owenosborn/imx6ulz-brain/production-r0/pictures/EX-PCB-10108-001_top.png

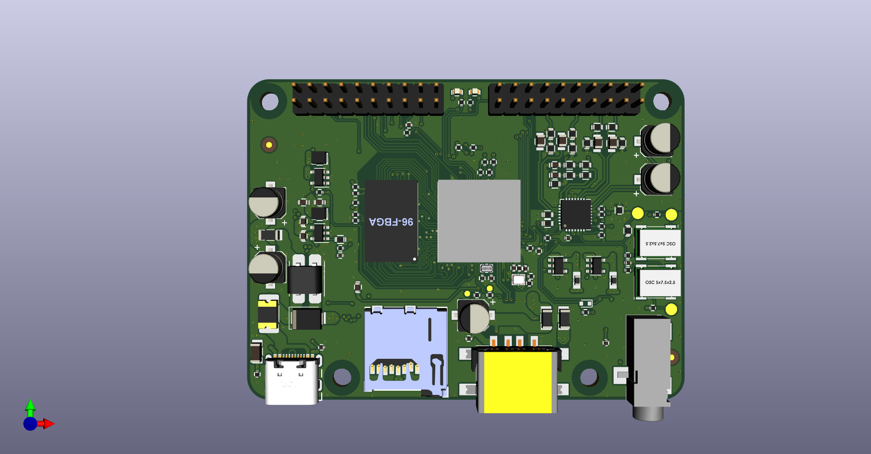
production-r0/pictures/EX-PCB-10108-001_top.png
