owenosborn/imx6ulz-brain/documentation/Audio Codec Board - PROTO_v102_Schematic.PDF

# Audio Codec Board - PROTO schematic v102

## STEREO

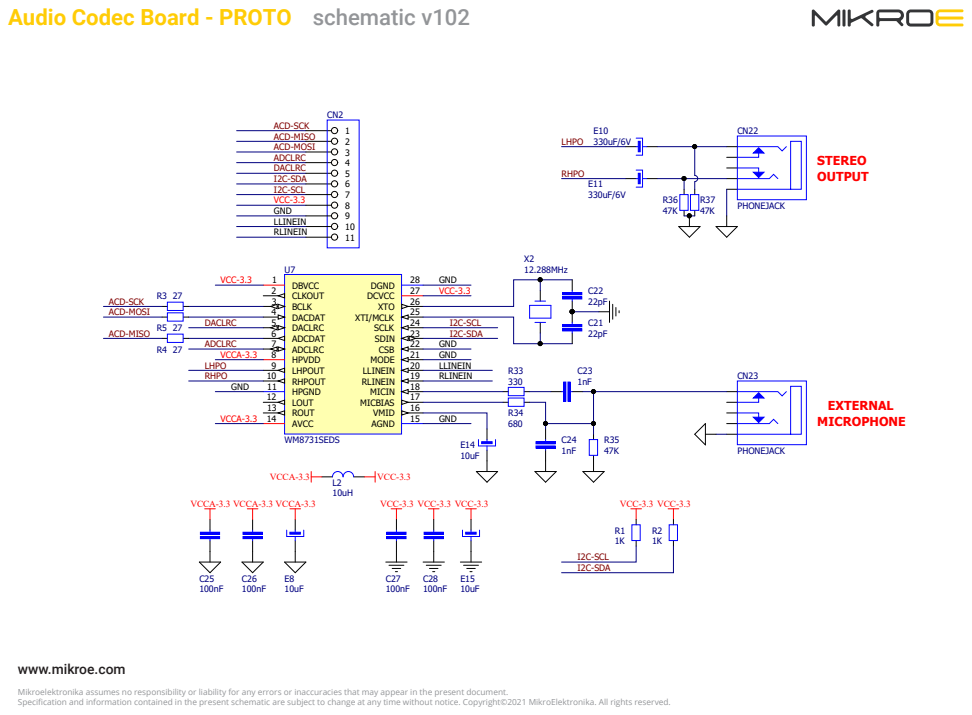
[picture p3: page 1]

Mikroelektronika assumes no responsibility or liability for any errors or inaccuracies that may appear in the present document.
Specification and information contained in the present schematic are subject to change at any time without notice. Copyright©2021 MikroElektronika. All rights reserved.
