owenosborn/imx6ulz-brain/production-r0/schematic/EX-PCB-10108-001.pdf

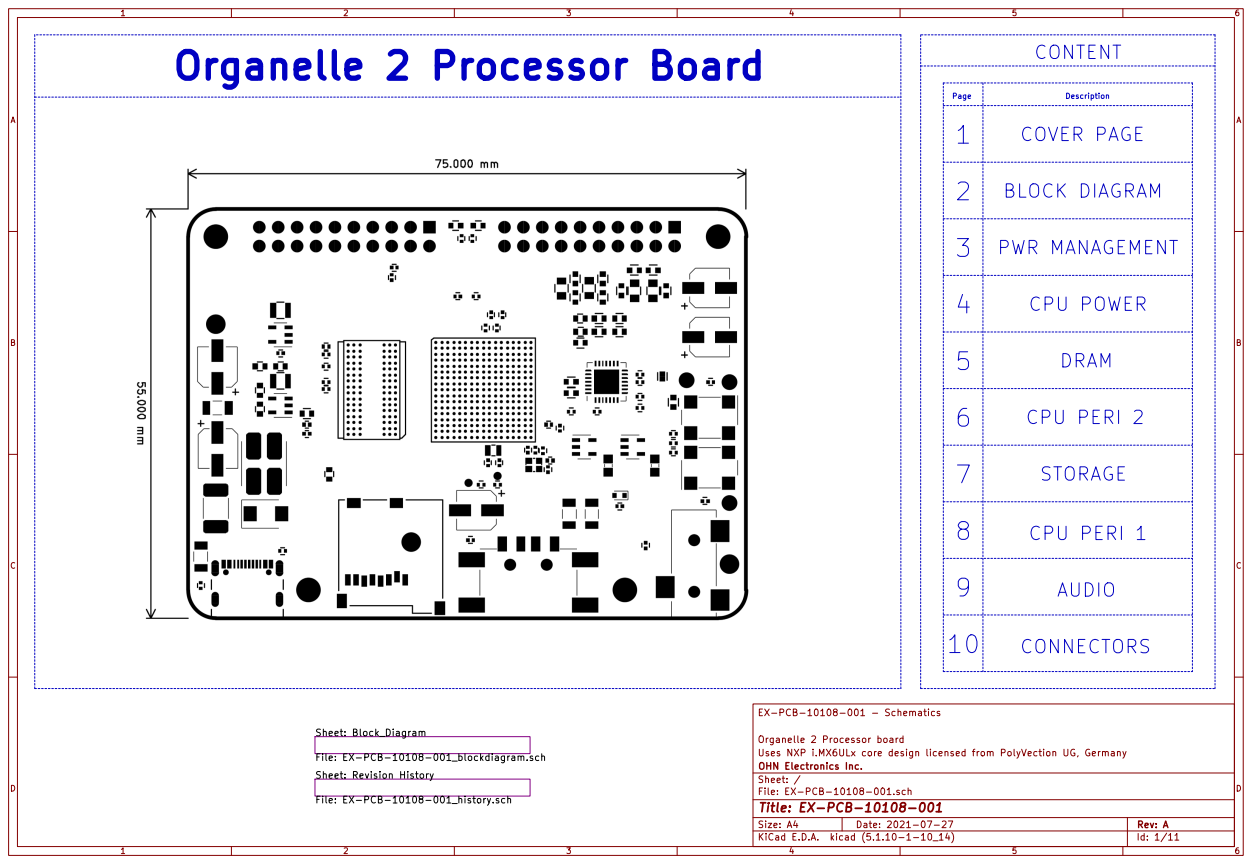
[picture p4: page 1]

2 | BLOCK DIAGRAM

3 | PWR MANAGEMENT

CPU POWER

5 | | DRAM

6 | CPU PERI 2

7 | STORAGE

8 | CPU PERI 1

9 | AUDIO

Organelle 2 Processor board EX-PCB-10108-001 - Schematics Sheet: Block_Diagram

File: EX-PCB-10108-001.sch Sheet: / OHN Electronics Inc. Uses NXP i.MX6ULx core design licensed from PolyVection UG, Germany

File: EX-PCB-10108-001_blockdiagram.sch
Sheet: Revision History

Id: 1/11 Title: EX-PCB-10108-001

File: EX-PCB-10108-001_history.sch

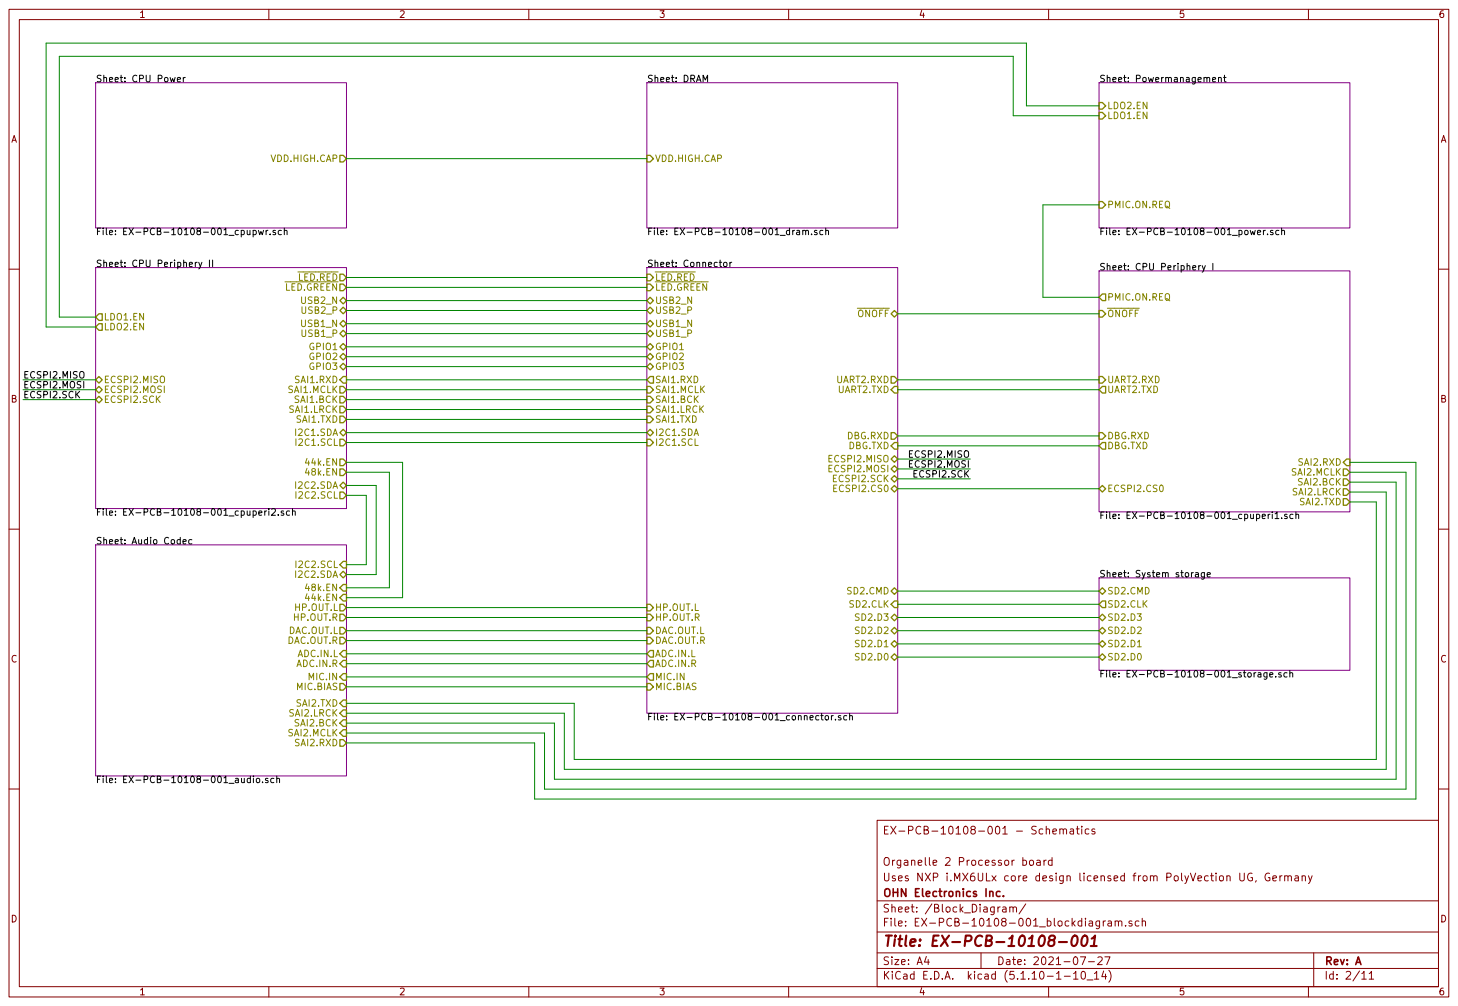
[picture p5: page 2]

File: EX-PCB-10108-001_dram.sch VDD.HIGH.CAP

File: EX-PCB-10108-001_power.sch PMIC.ON.REQ

Sheet: CPU Periphery II

ECSPI2.CS0 Sheet: Connector File: EX-PCB-10108-001_connector.sch USB2_N
LED.RED
LED.GREEN
UART2.RXD ONOFF ECSPI2.MISO

File: EX-PCB-10108-001_cpuperi1.sch PMIC.ON.REQ

File: EX-PCB-10108-001_cpuperi2.sch

I2C2.SCL
I2C2.SDA MIC.IN MIC.BIAS
SAI2.MCLK HP.OUT.L HP.OUT.R

Sheet: System storage
SD2.CMD
File: EX-PCB-10108-001_storage.sch SD2.CLK

HP.OUT.L
HP.OUT.R
DAC.OUT.L ADC.IN.R
ADC.IN.L DAC.OUT.R

DAC.OUT.L DAC.OUT.R

Organelle 2 Processor board EX-PCB-10108-001 - Schematics

Sheet: /Block_Diagram/ OHN Electronics Inc. Uses NXP i.MX6ULx core design licensed from PolyVection UG, Germany

File: EX-PCB-10108-001_blockdiagram.sch
Id: 2/11 Title: EX-PCB-10108-001

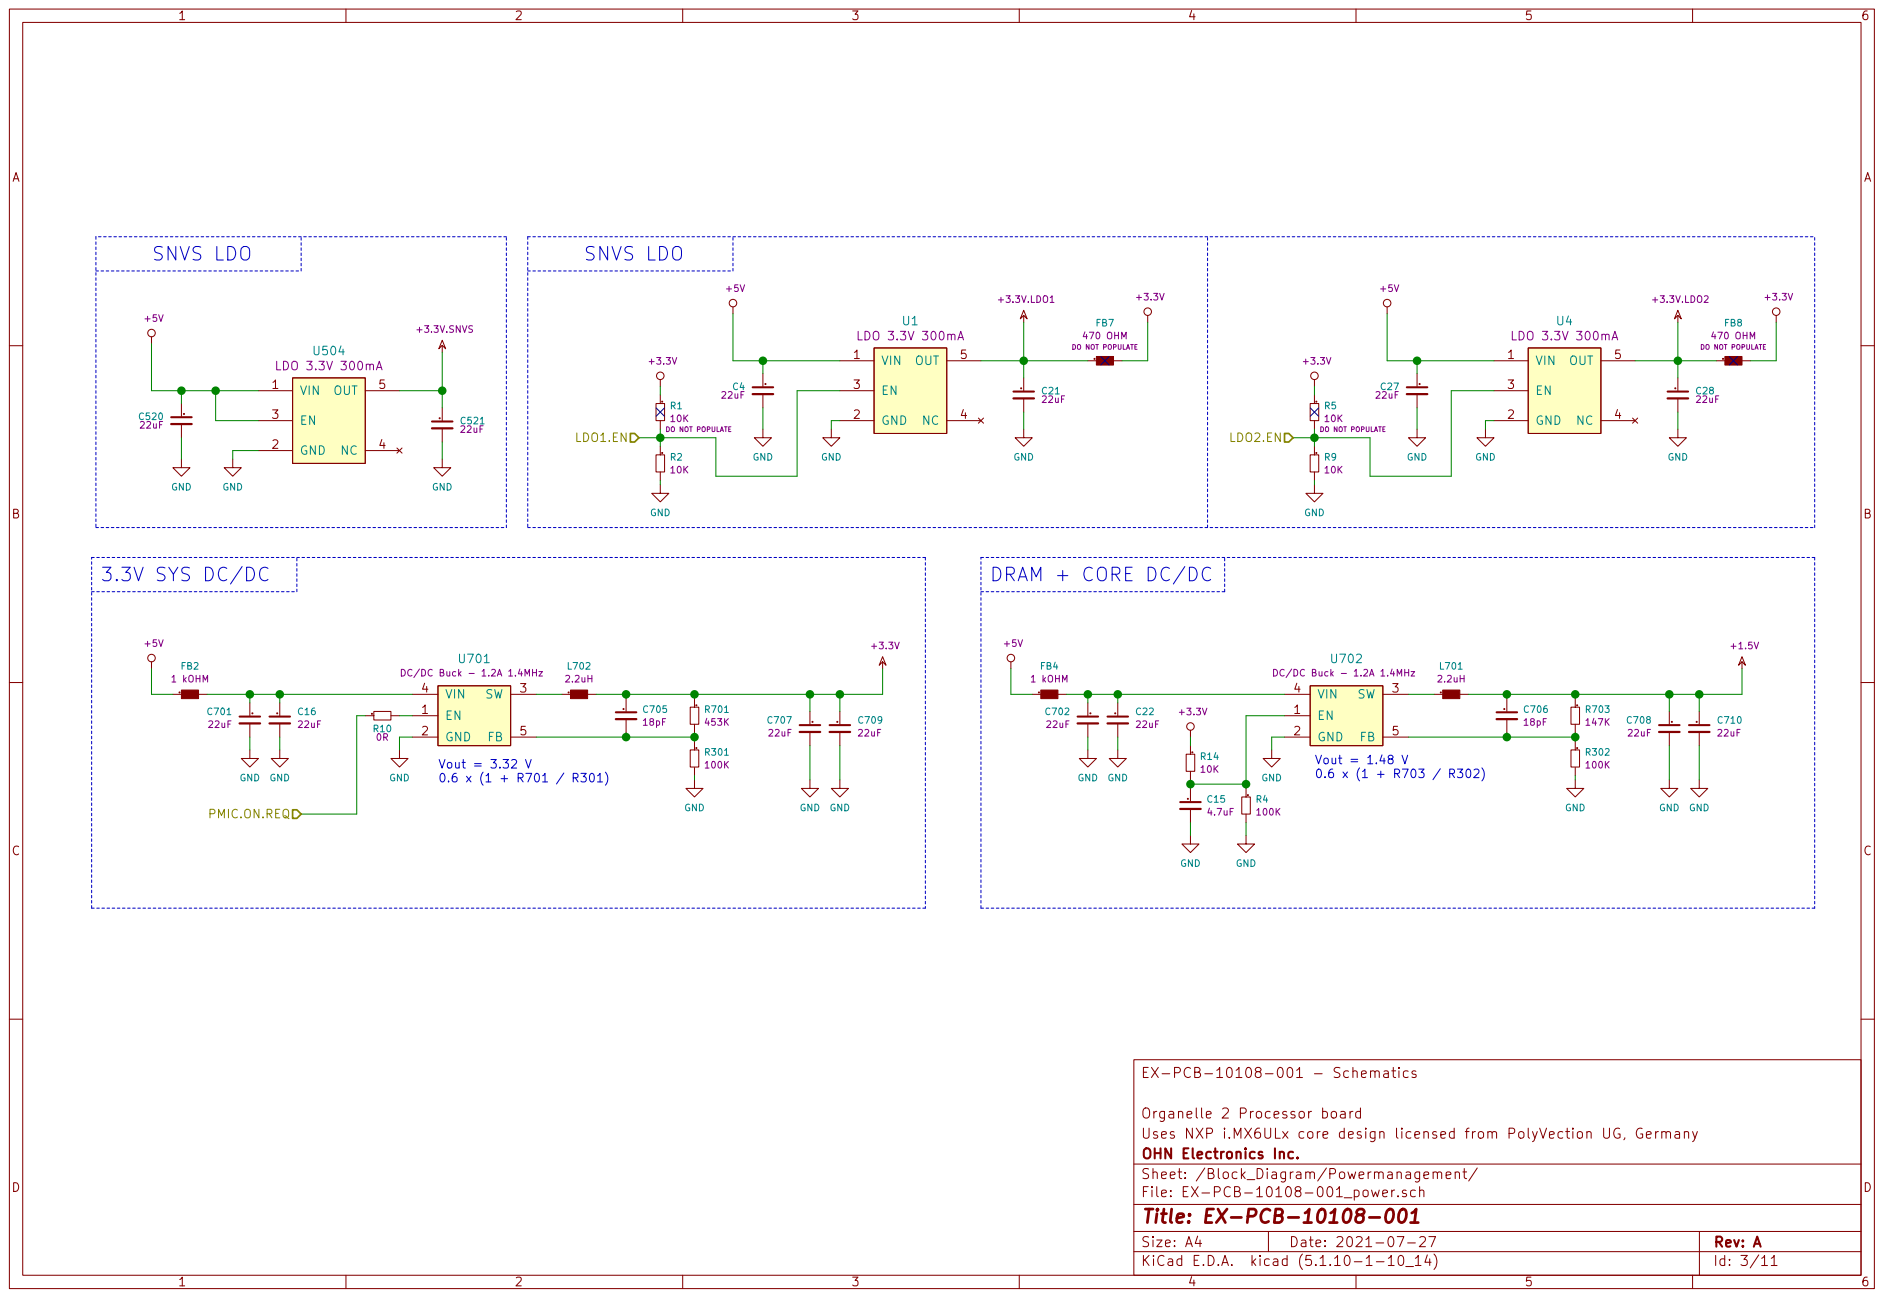
[picture p6: page 3]

DO NOT POPULATE GND

Organelle 2 Processor board EX-PCB-10108-001 - Schematics

Sheet: /Block_Diagram/Powermanagement/ OHN Electronics Inc. Uses NXP i.MX6ULx core design licensed from PolyVection UG, Germany

File: EX-PCB-10108-001_power.sch
Id: 3/11 Title: EX-PCB-10108-001

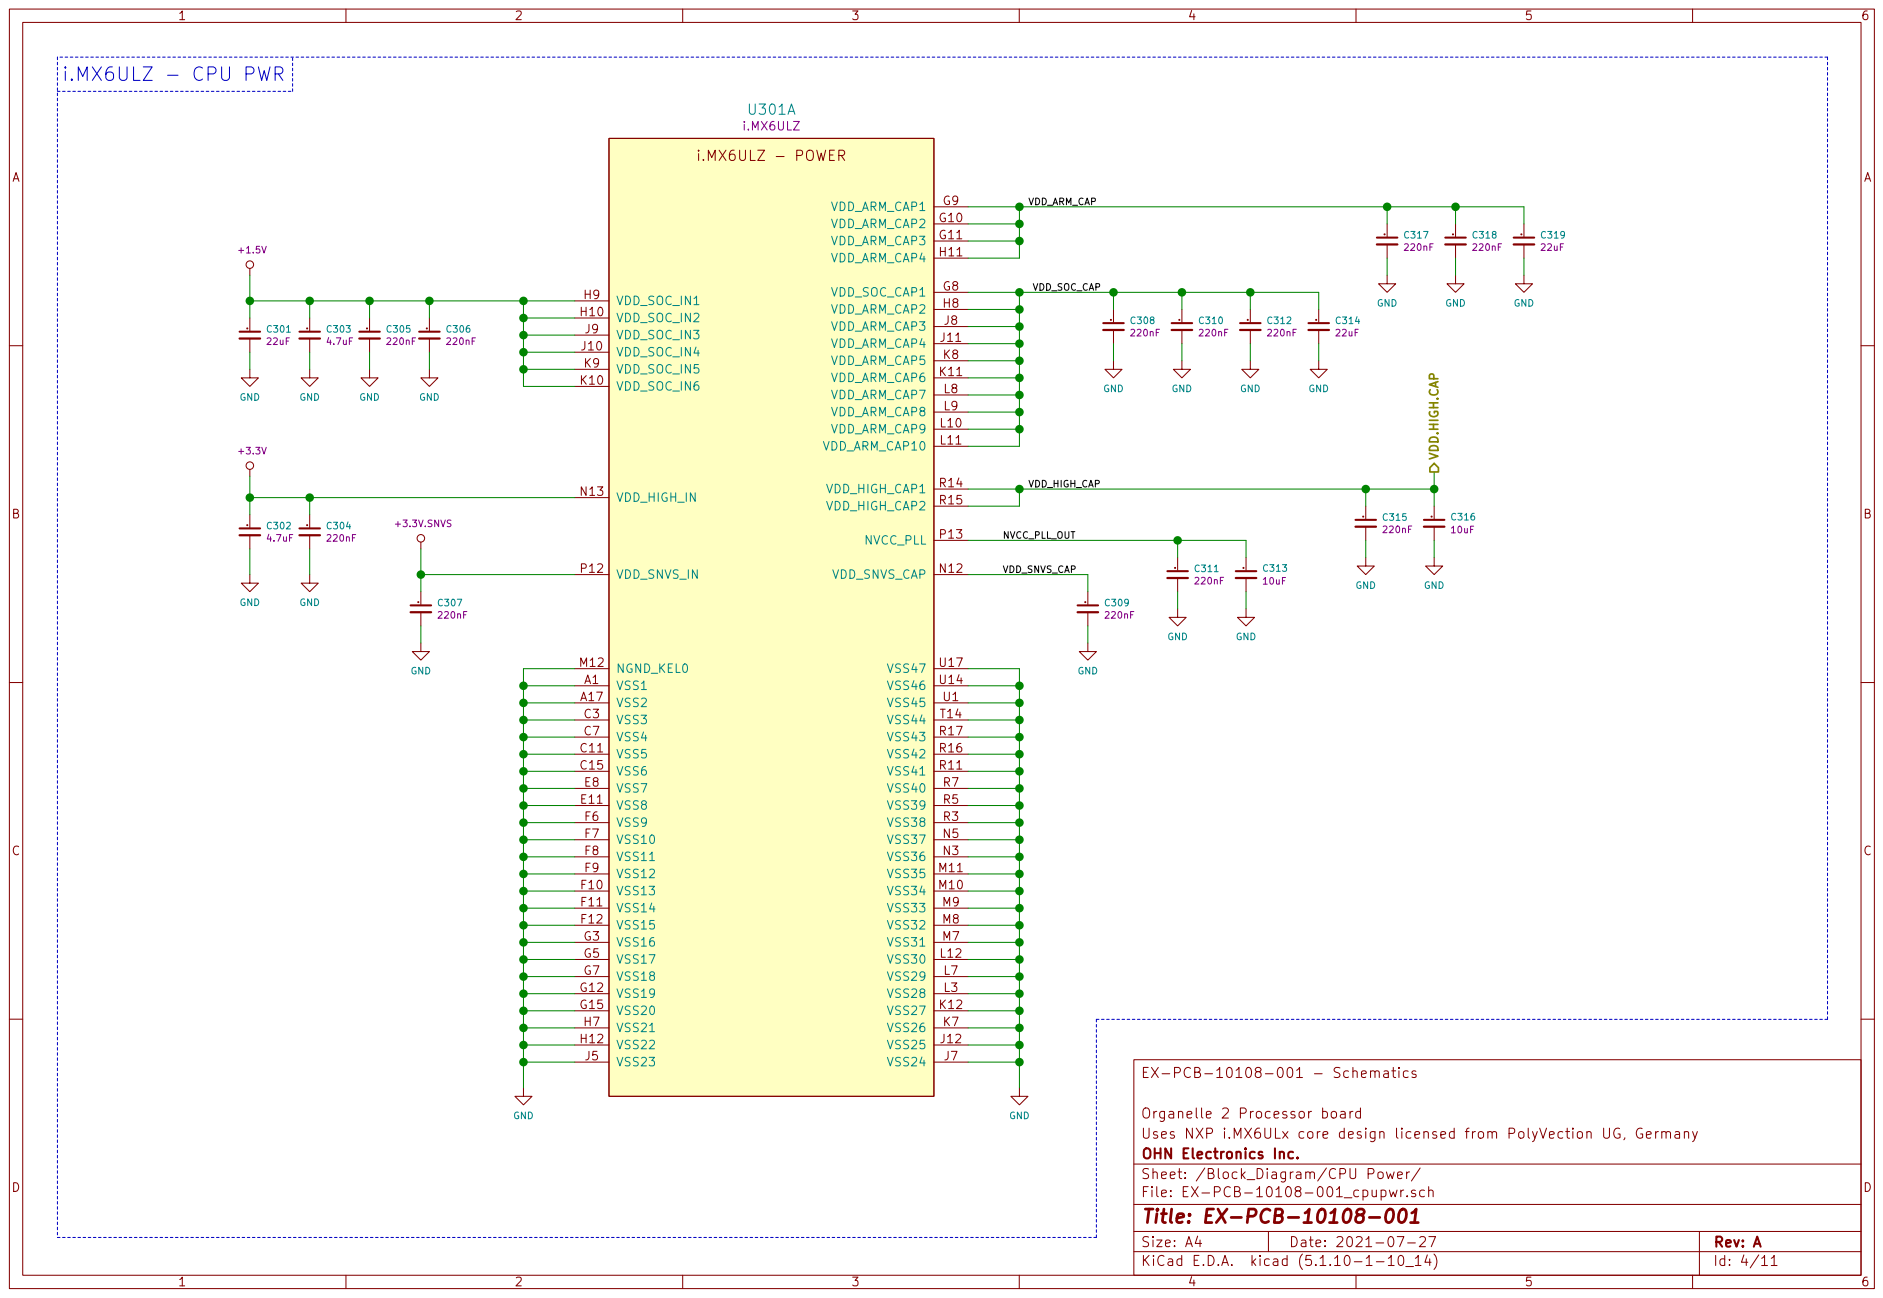
[picture p7: page 4]

Organelle 2 Processor board EX-PCB-10108-001 - Schematics

Sheet: /Block_Diagram/CPU Power/ OHN Electronics Inc. Uses NXP i.MX6ULx core design licensed from PolyVection UG, Germany

File: EX-PCB-10108-001_cpupwr.sch
Id: 4/11 Title: EX-PCB-10108-001

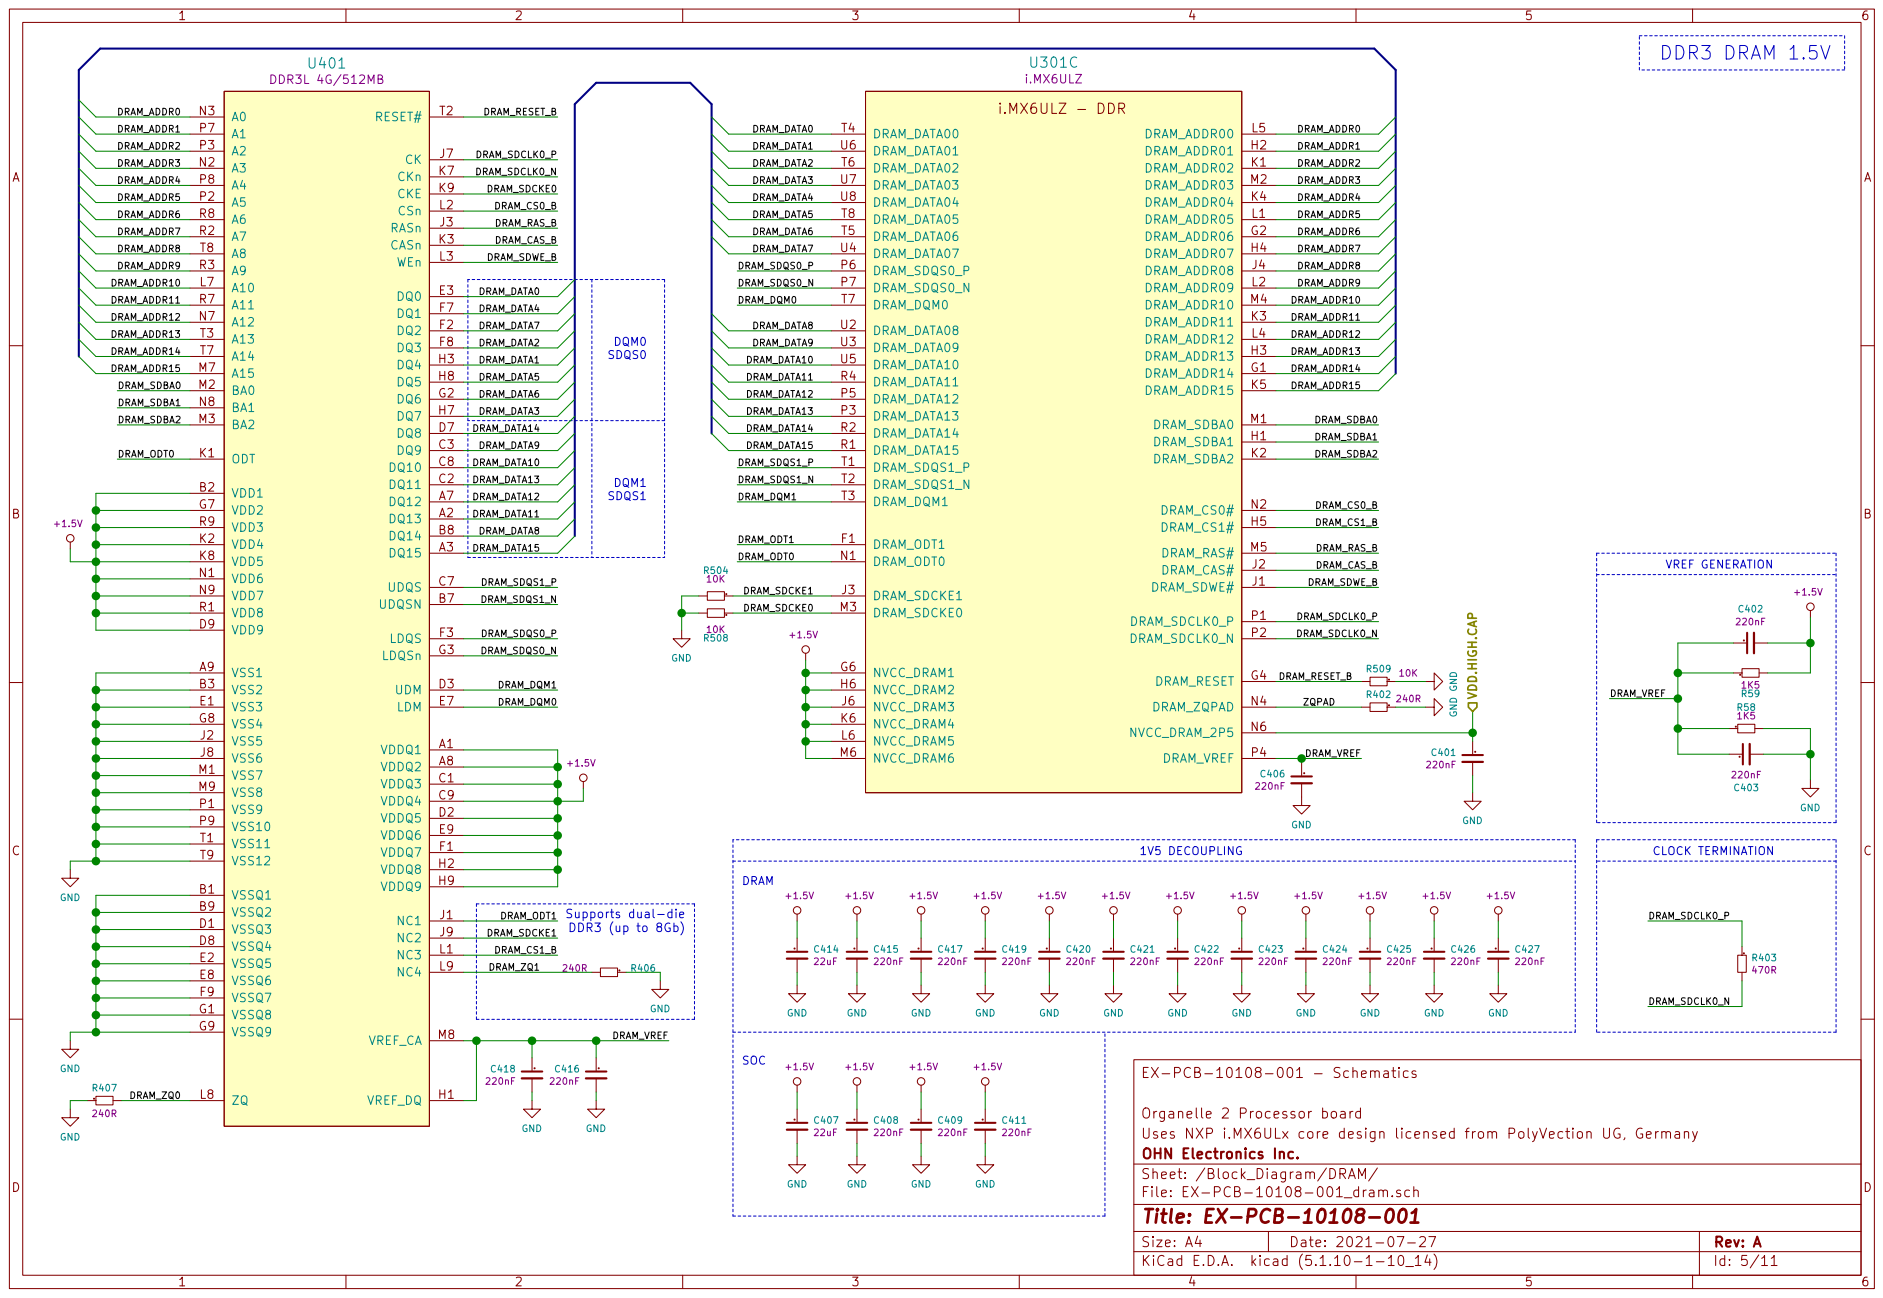
[picture p8: page 5]

Sheet: /Block_Diagram/DRAM/ OHN Electronics Inc. Uses NXP i.MX6ULx core design licensed from PolyVection UG, Germany

File: EX-PCB-10108-001_dram.sch
Id: 5/11 Title: EX-PCB-10108-001

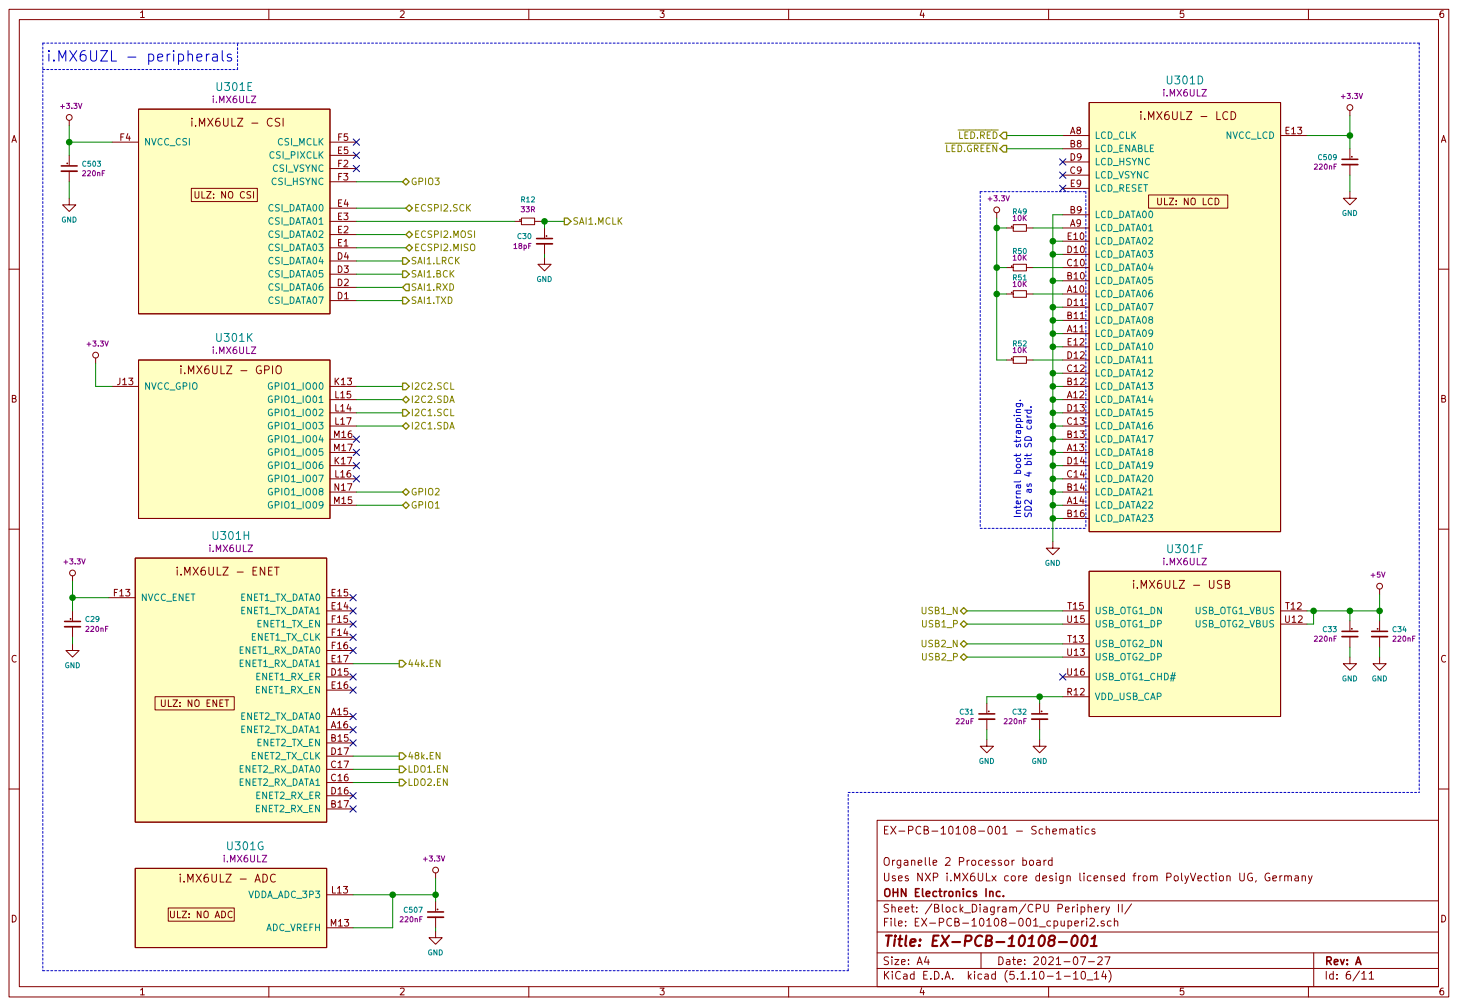
[picture p9: page 6]

Organelle 2 Processor board EX-PCB-10108-001 - SchematicsGND

Sheet: /Block_Diagram/CPU Periphery II/ OHN Electronics Inc. Uses NXP i.MX6ULx core design licensed from PolyVection UG, Germany

File: EX-PCB-10108-001_cpuperi2.sch
Id: 6/11 Title: EX-PCB-10108-001

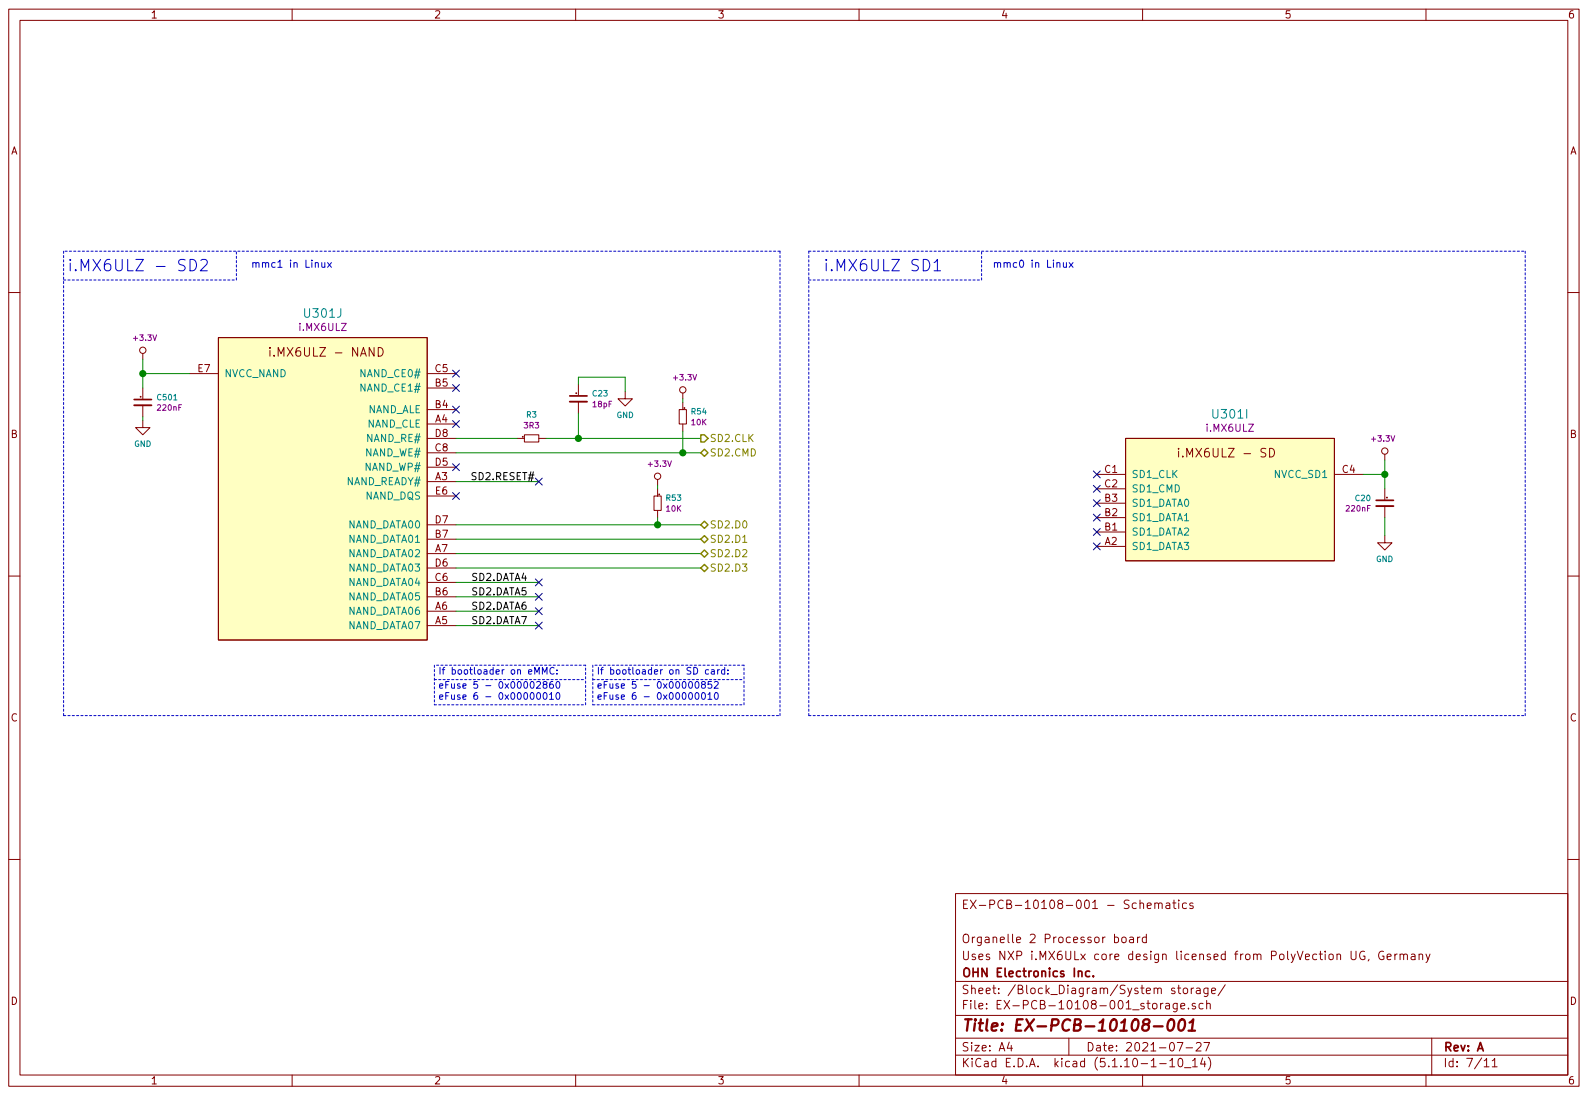
[picture p10: page 7]

If bootloader on SD card: eFuse 5 - 0x00002860

Organelle 2 Processor board EX-PCB-10108-001 - Schematics

Sheet: /Block_Diagram/System storage/ OHN Electronics Inc. Uses NXP i.MX6ULx core design licensed from PolyVection UG, Germany

File: EX-PCB-10108-001_storage.sch
Id: 7/11 Title: EX-PCB-10108-001

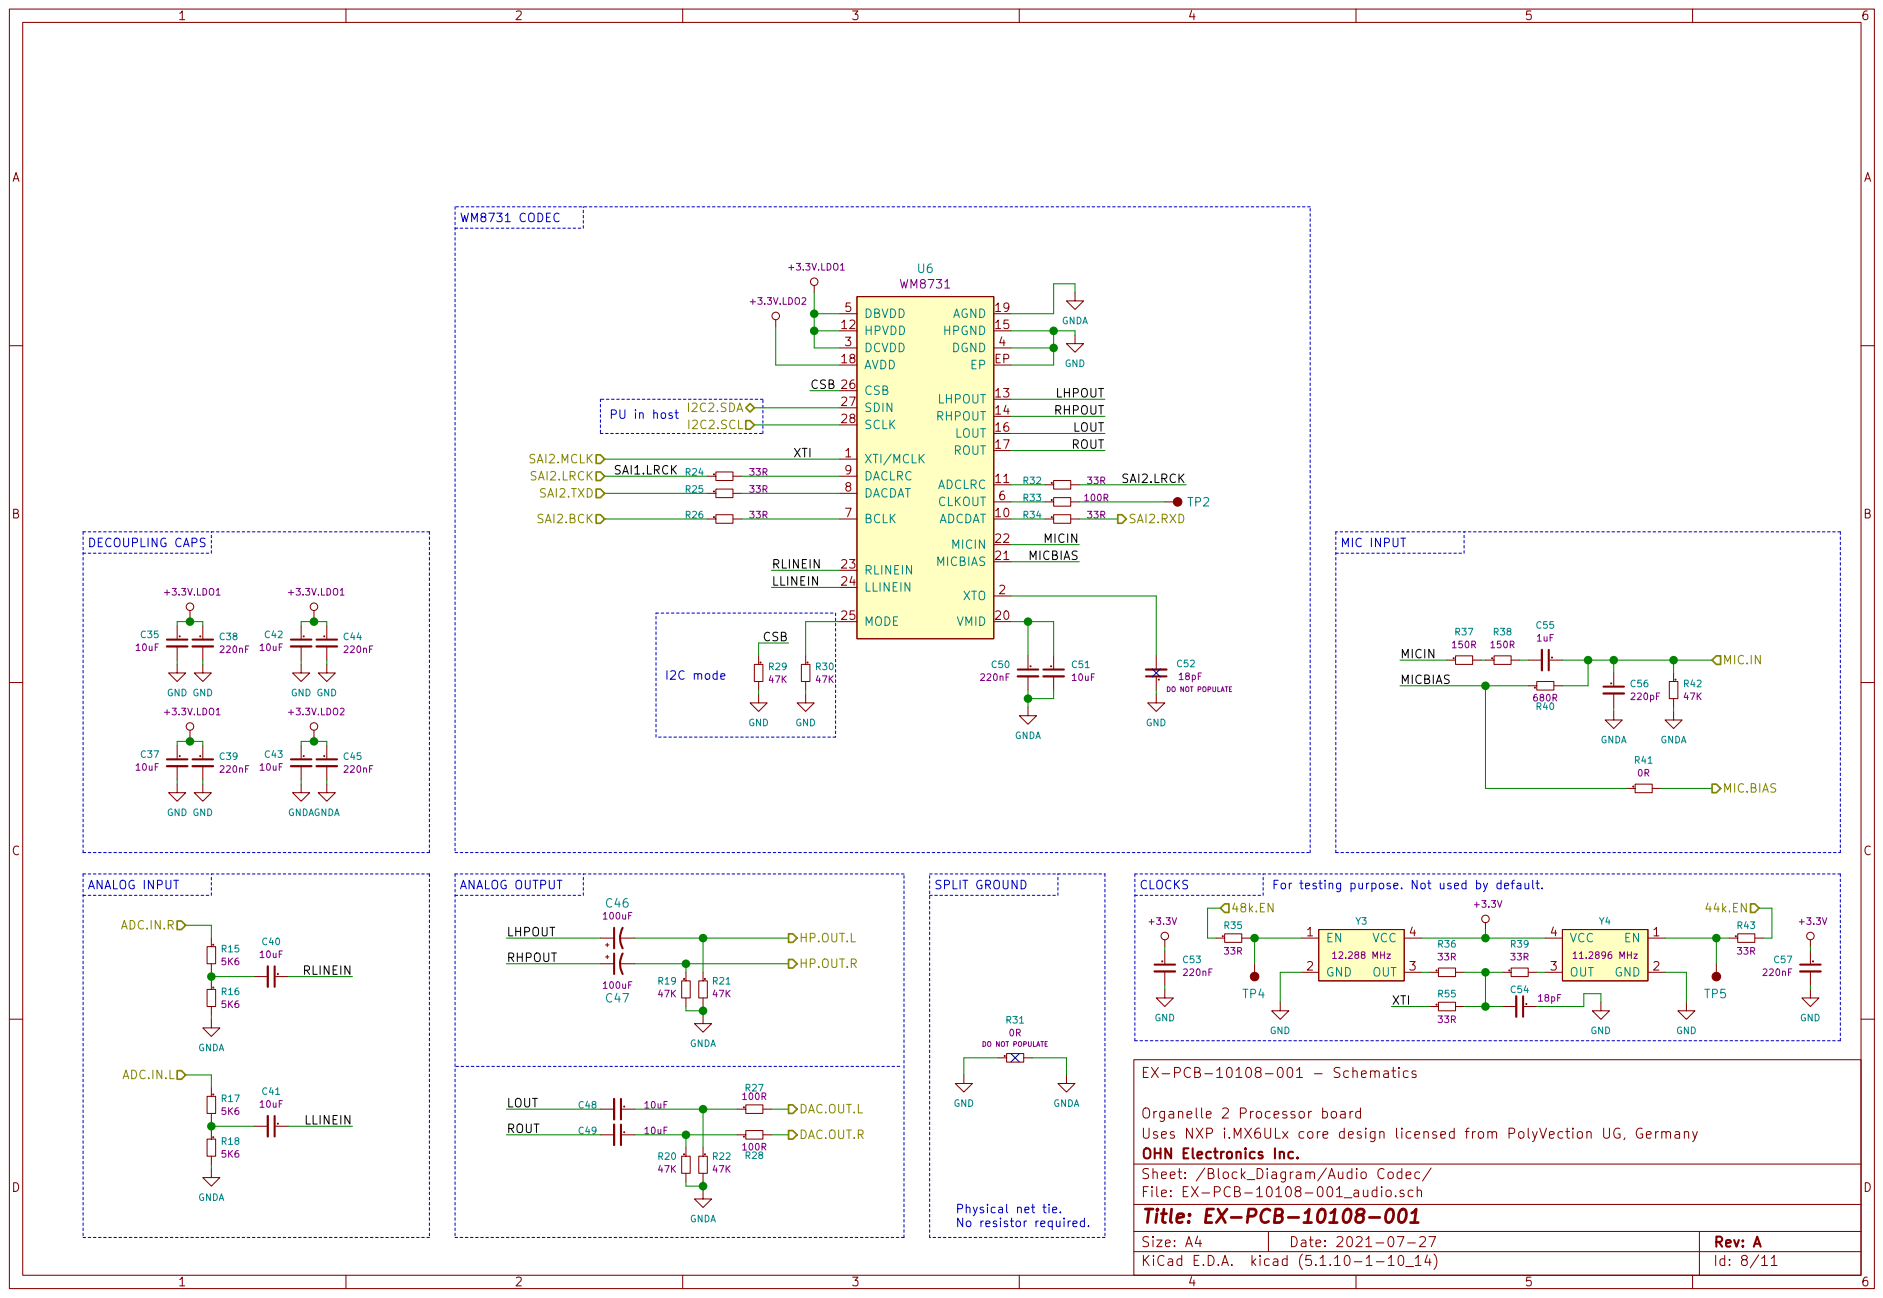
[picture p11: page 8]

DO NOT POPULATE GNDA C41

Organelle 2 Processor board EX-PCB-10108-001 - Schematics Sheet: /Block_Diagram/Audio Codec/ OHN Electronics Inc. Uses NXP i.MX6ULx core design licensed from PolyVection UG, Germany

File: EX-PCB-10108-001_audio.sch
Id: 8/11 Title: EX-PCB-10108-001

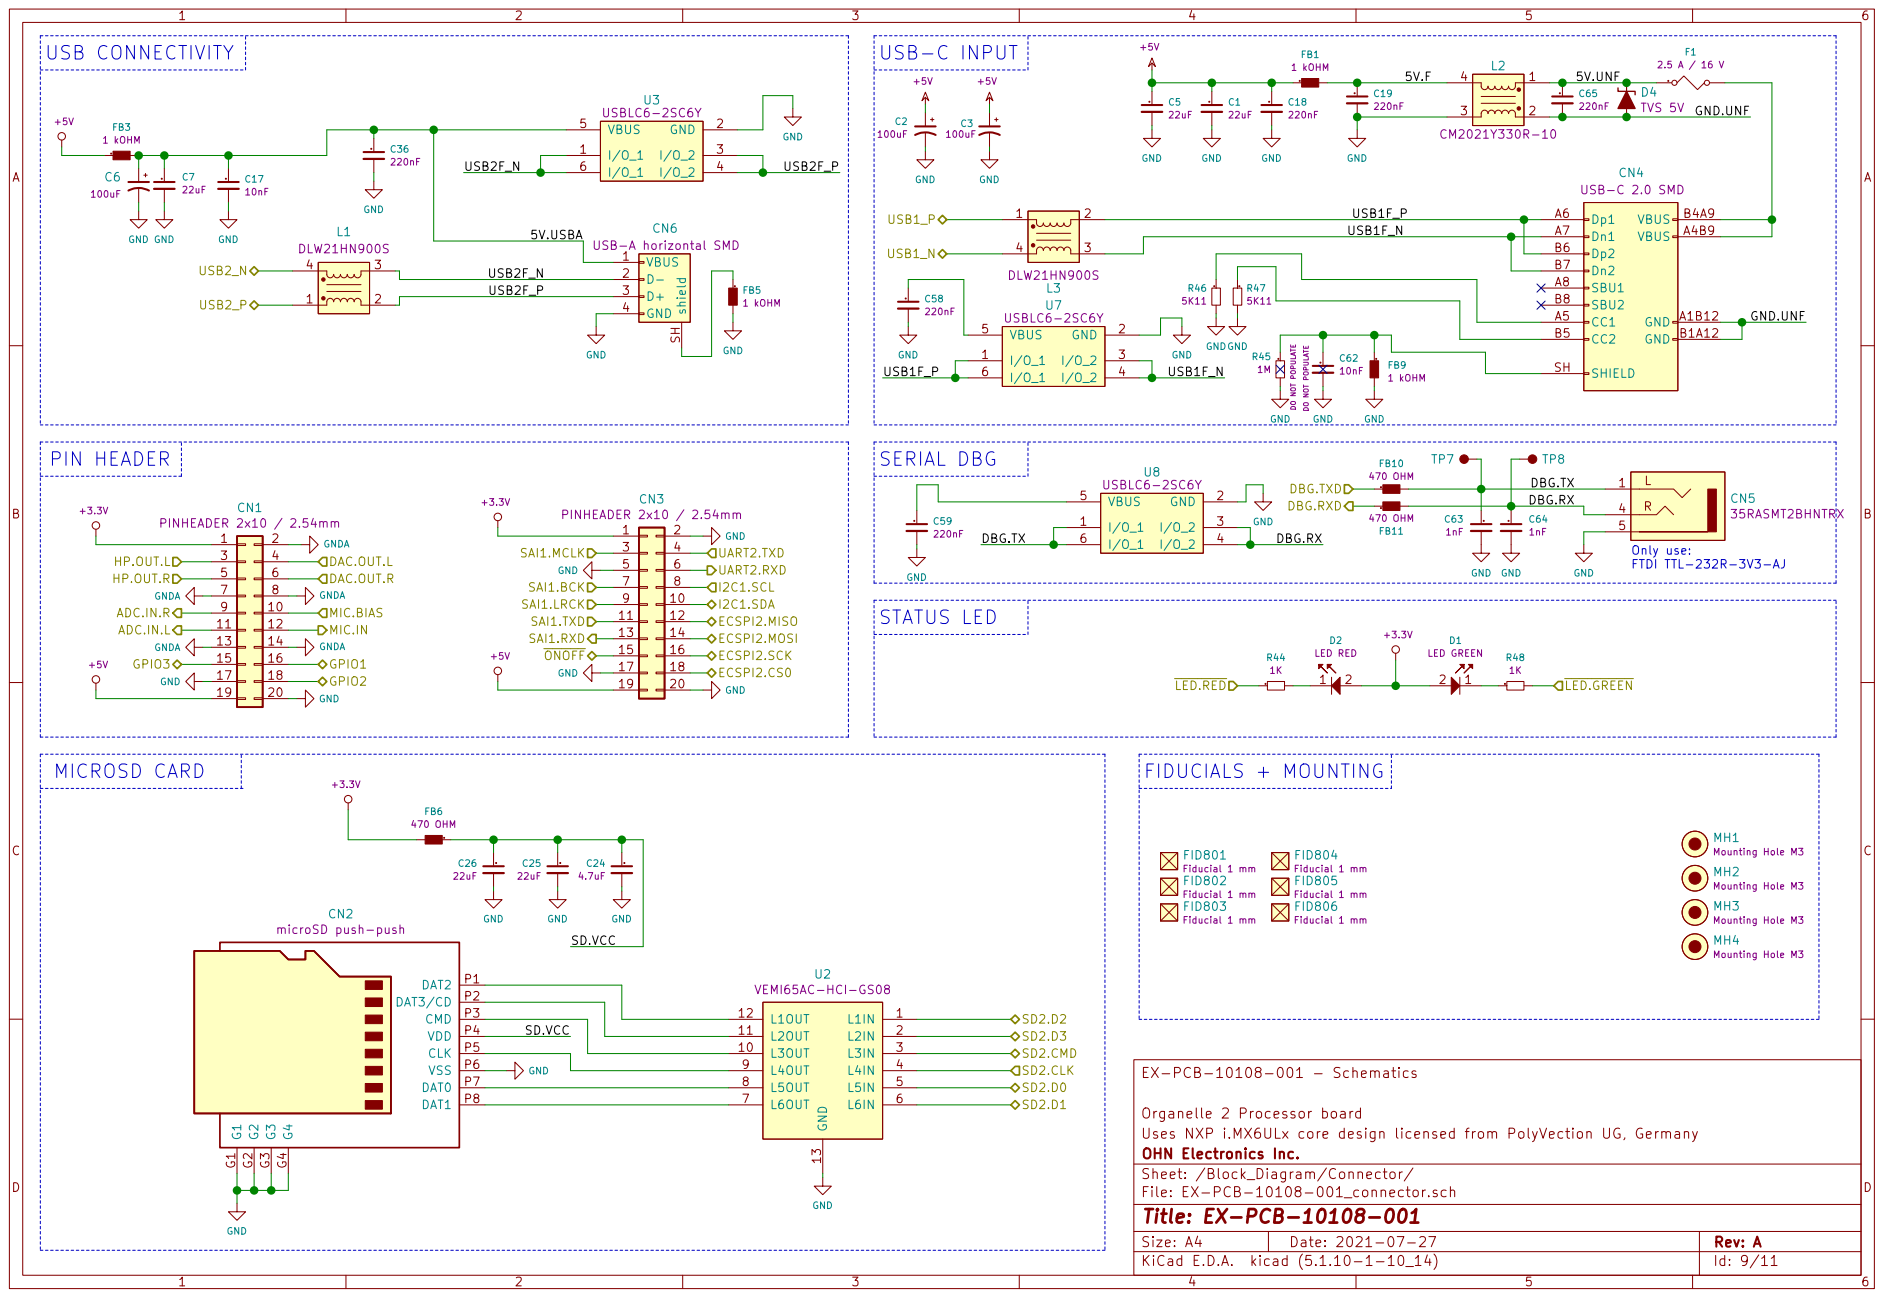
[picture p12: page 9]

DAC.OUT.L HP.OUT.R

Only use: FTDI TTL-232R-3V3-AJ

ADC.IN.L ADC.IN.R

470 OHM MIC.BIAS MIC.IN

Organelle 2 Processor board EX-PCB-10108-001 - Schematics

Sheet: /Block_Diagram/Connector/ OHN Electronics Inc. Uses NXP i.MX6ULx core design licensed from PolyVection UG, Germany

File: EX-PCB-10108-001_connector.sch
Id: 9/11 Title: EX-PCB-10108-001

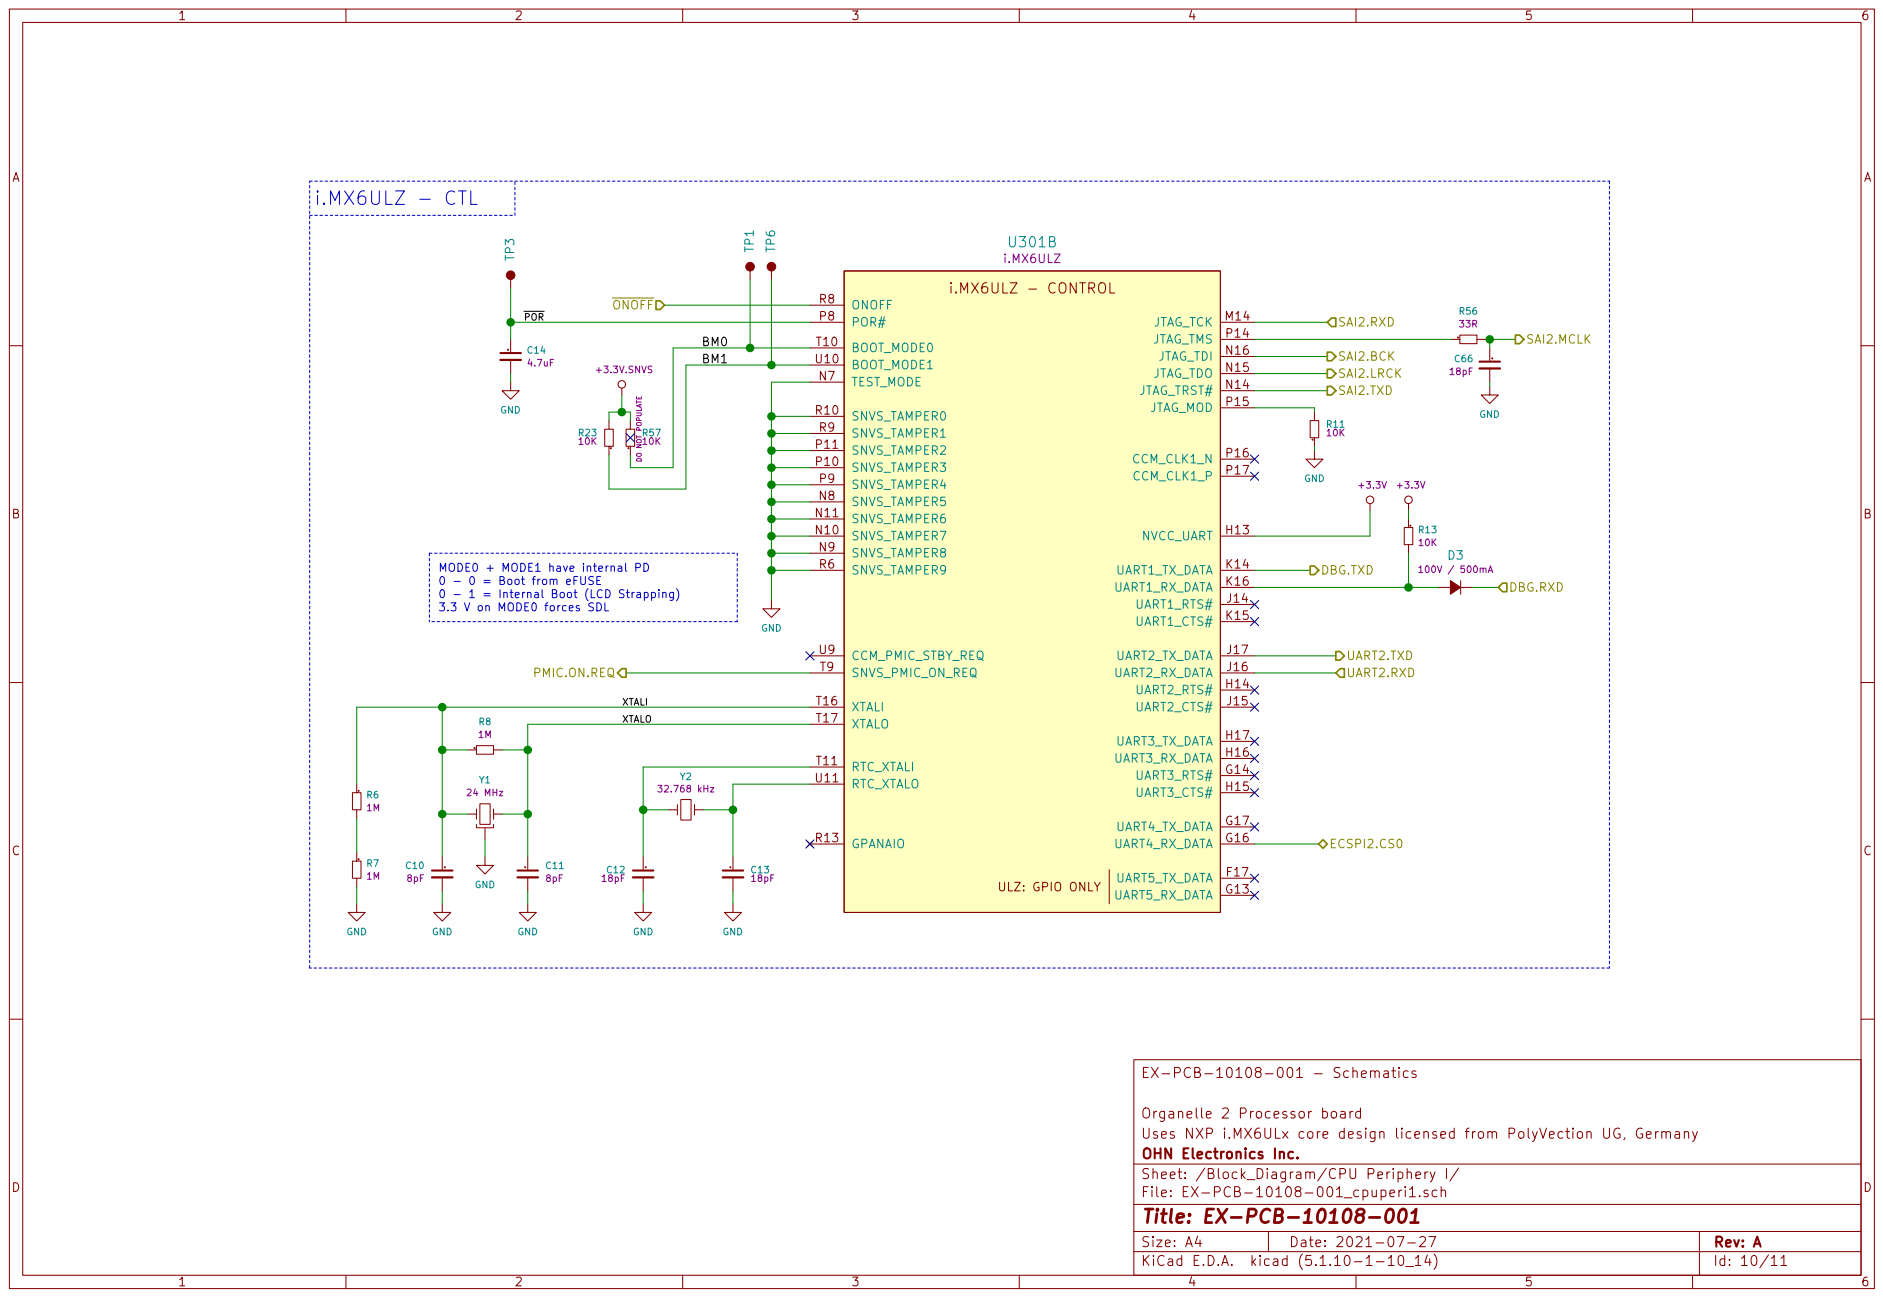
[picture p13: page 10]

XTALI MODE0 + MODE1 have internal PD
0 - 0 = Boot from eFUSE
0 - 1 = Internal Boot (LCD Strapping) 3.3 V on MODE0 forces SDL

Organelle 2 Processor board EX-PCB-10108-001 - Schematics

Sheet: /Block_Diagram/CPU Periphery I/ OHN Electronics Inc. Uses NXP i.MX6ULx core design licensed from PolyVection UG, Germany

File: EX-PCB-10108-001_cpuperi1.sch
Id: 10/11 Title: EX-PCB-10108-001

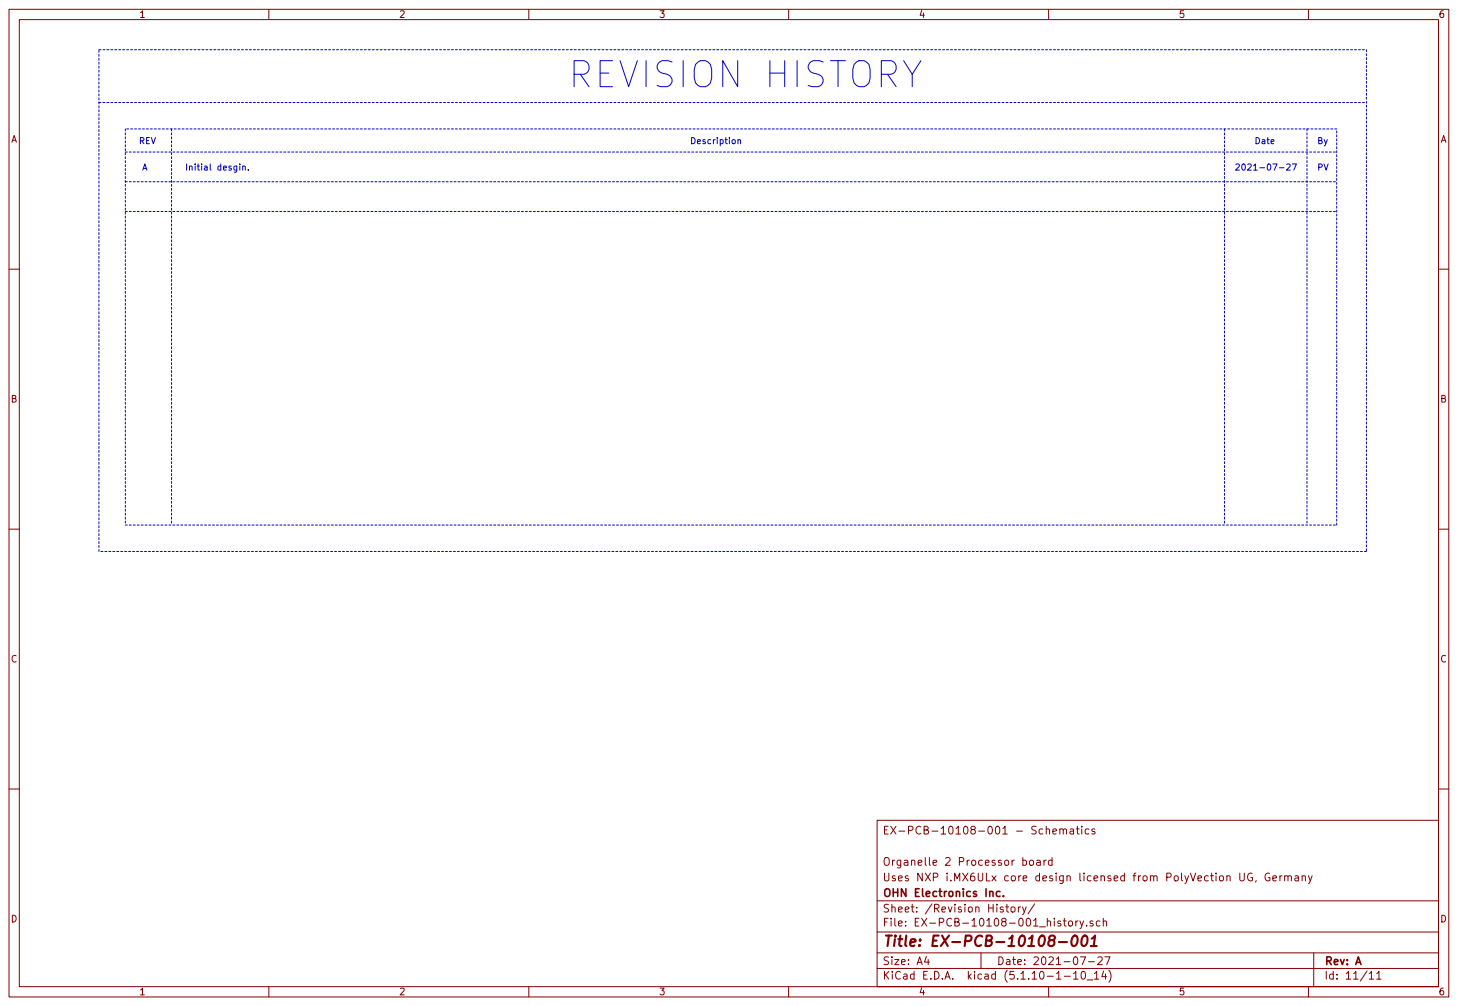
[picture p14: page 11]

Organelle 2 Processor board EX-PCB-10108-001 - Schematics REVISION HISTORY

Sheet: /Revision History/ OHN Electronics Inc. Uses NXP i.MX6ULx core design licensed from PolyVection UG, Germany

File: EX-PCB-10108-001_history.sch
Id: 11/11 Title: EX-PCB-10108-001
