owenosborn/imx6ulz-brain/documentation/SCH-29364_SPF-29364_A1.pdf

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
## SO-DIMM

# Table of Content

## Cover

## Block Diagram

# Page 1

# Page 2

# Page 3

# Page 4

# Page 5

# Page 6

# Page 7

# Page 8

# Page 9

# Page 10

# Page 11

# Page 12

# Page 13

# Page 14

# Page 15

# Page 16

# Page 17

# Page 18

# Page 19

# Page 20

# Page 21

# Revision History

Rev. Code | Date | Description By

# MCIMX6ULL-CM

# Page 22

# 1. Unless Otherwise Specified: All resistors are in ohms, 10%, 1/8 Watt,0603 All capacitors are in uF, 20%, 50V,0603 All voltages are DC All polarized capacitors are aluminum electrolytic

# 2. Interrupted lines coded with the same letter or letter

combinations are electrically connected.

# 3. Device type number is for reference only. The number

varies with the manufacturer.

# 4. Special signal usage: _B Denotes - Active-Low Signal <> or [] Denotes - Vectored Signals 5. Interpret diagram in accordance with American National Standards Institute specifications, current

revision, with the exception of logic block symbology.

# Page 23

# Page 24

# Page 25

## CPU PWR

# Schematics DevBoard

# Page 26

# Page 26

# Page 27

# Page 28

## PWR TREE

2016-07-22 | Yizhou | Compare to i.MX 6UL EVK C3
| | 1

## LvDDR3

## eMMC/NAND/TF/QSPI

## CPU PERI1

## CPU PERI2

## BOOT CFG

## PWR MGR

## NOTE

## IOMUX

2
3
4

### Change U101 CPU part number to MCIMX6Y2DVM05AA

### Change DDR part number to MT41K256M16TW-107:P Change QSPI flash part number to MT25QL256ABA1EW9 Remove EVMSIM

A1 | 25-May-2018 | Marek B. | U101 updated to MCIMX6Y2DVM09AB

Drawing Title:

Size | Document Number | Rev
Date: | Sheet | of

Page Title:

Designer:

Drawn by:

Approved:

### Microcontroller Product Group

6501 William Cannon Drive West
Austin, TX 78735-8598
This document contains information proprietary to NXP and shall not be used for engineering design, procurement or manufacture in whole or in part without the express written permission of NXP Semiconductors.
ICAP Classification: | CP: | IUO: | PUBI:
SCH-29364 PDF: SPF-29364 | A1

## MCIMX6ULL-CM

C

Friday, May 25, 2018

### Title and Rev History

<Designer>

<Approver>

<DrawnBy>

1 | 13 ___ | _X_ | ___ Drawing Title: Size | Document Number | Rev Date: | Sheet | of Page Title: Designer: Drawn by: Approved:

### Microcontroller Product Group

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

## MCIMX6ULL-CM

C

### Title and Rev History

<Designer>

<Approver>

<DrawnBy>

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

### Microcontroller Product Group

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

## MCIMX6ULL-CM

C

### Title and Rev History

<Designer>

<Approver>

<DrawnBy>

1 | 13 ___ | _X_ | ___

# i.MX6ULL EVK Block Diagram

# ##### Blcok Diagram Rev 1.0 #####

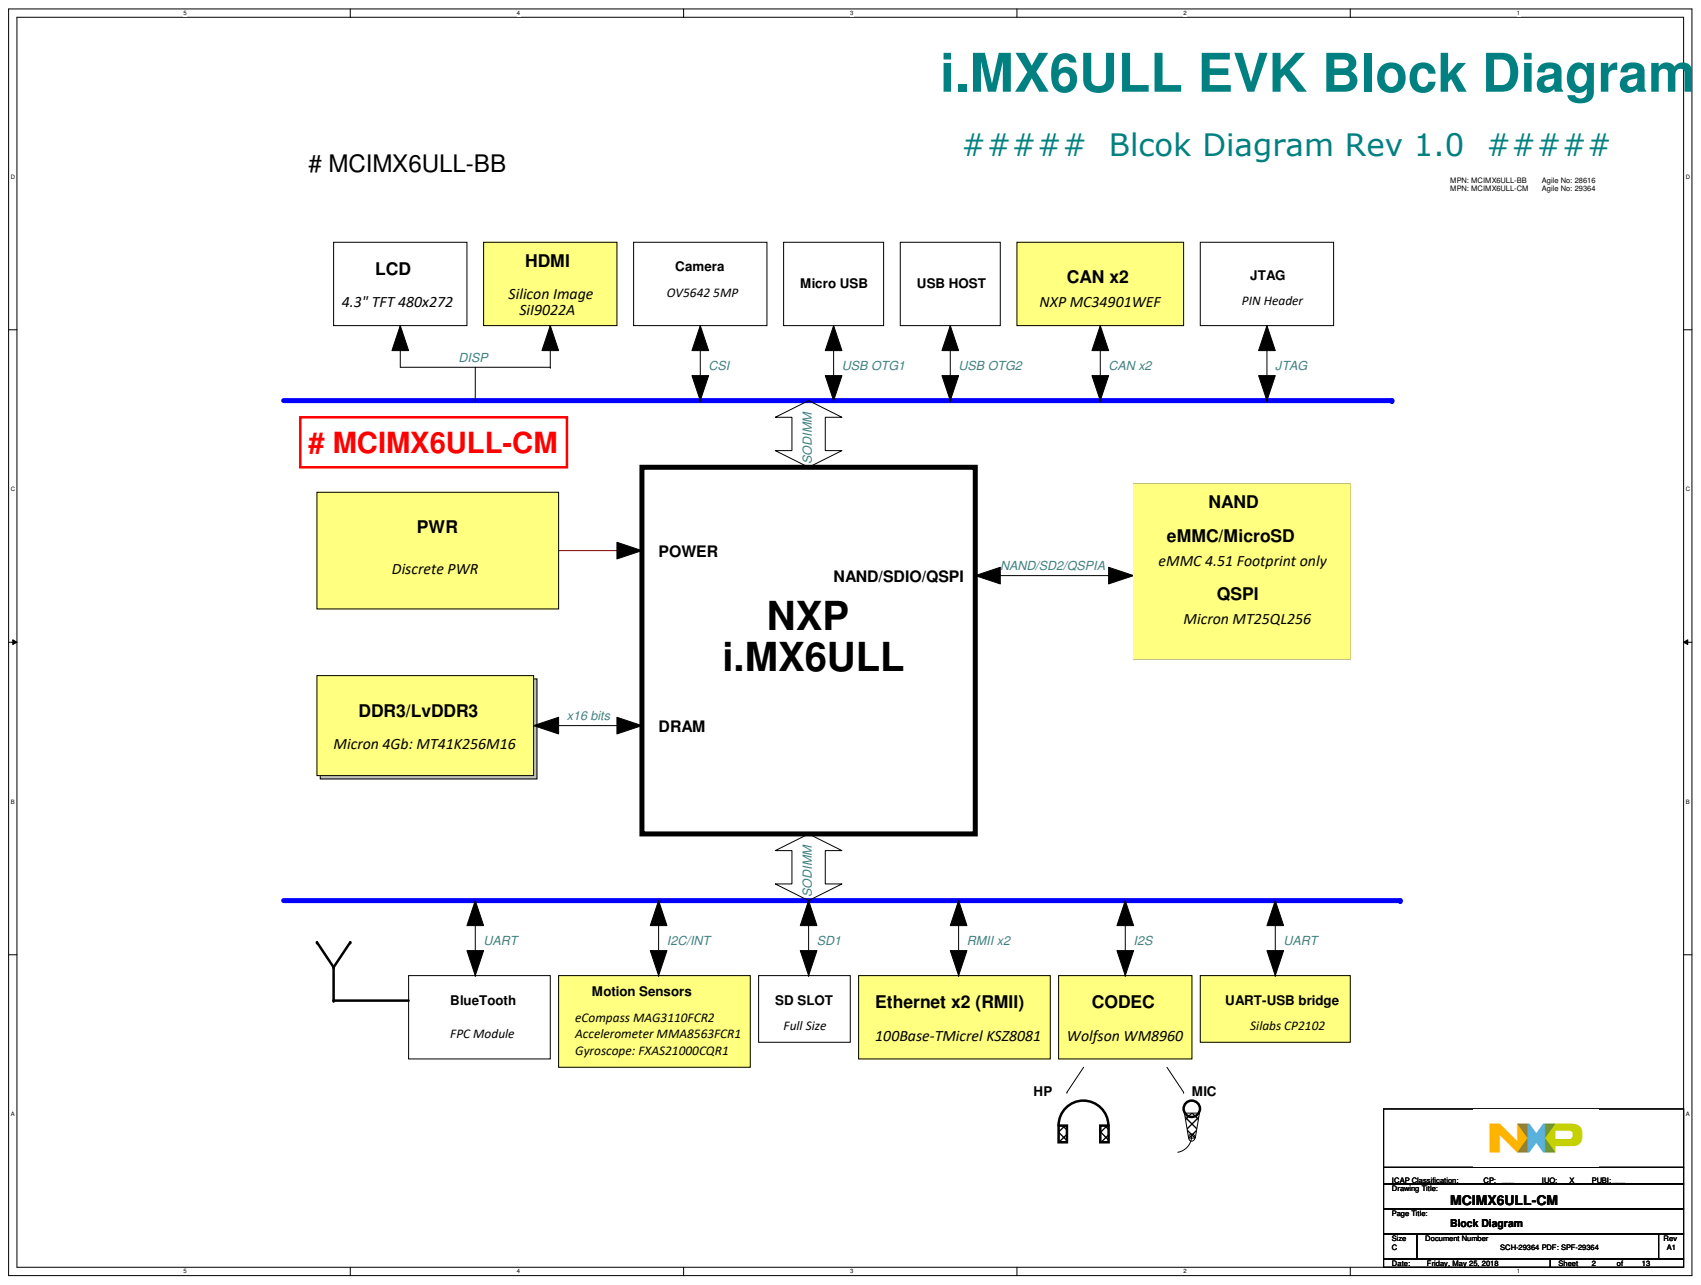
[picture p15: page 2]
Discrete PWR; PWR; POWER; NXP i.MX6ULL; # MCIMX6ULL-CM; DRAM; QSPI; Micron MT25QL256; NAND; eCompass MAG3110FCR2; Gyroscope: FXAS21000CQR1; Accelerometer MMA8563FCR1; CAN x2; NXP MC34901WEF; Ethernet x2 (RMII); 100Base-TMicrel KSZ8081; CODEC; Wolfson WM8960; MIC; BlueTooth; FPC Module; Silabs CP2102; JTAG; PIN Header; LCD; 4.3" TFT 480x272; HDMI; Silicon Image SiI9022A; DDR3/LvDDR3; Micron 4Gb: MT41K256M16; Camera; Micro USB; USB HOST; Motion Sensors; SD SLOT; Full Size; DISP; CSI; USB OTG1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

eMMC/MicroSD
eMMC 4.51 Footprint only

NAND/SDIO/QSPI

UART-USB bridge

## DC/DC BUCK MPS MP2159

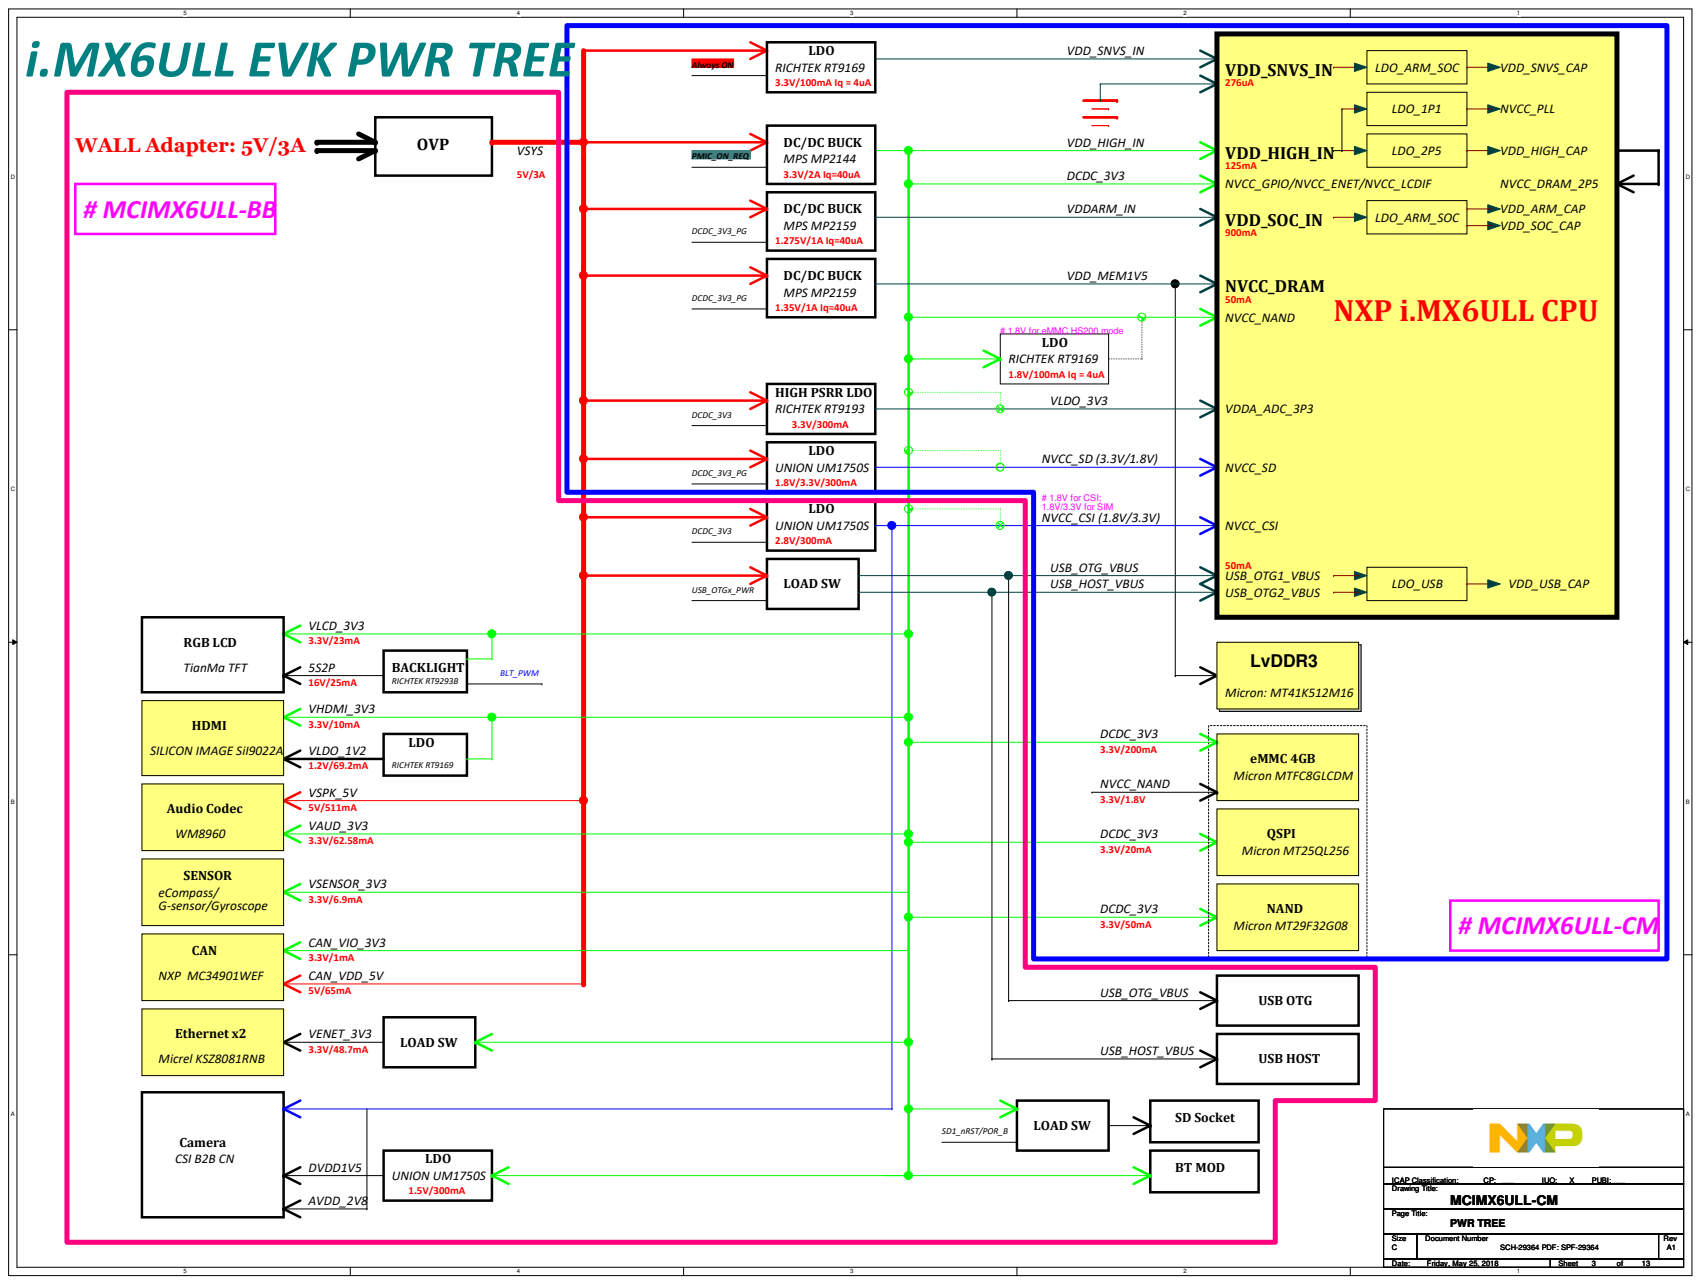
[picture p16: page 3]
NVCC_CSI; VDDA_ADC_3P3; LDO_ARM_SOC; LDO_2P5; LDO_1P1; NVCC_DRAM_2P5; USB_OTG2_VBUS; LDO RICHTEK RT9169; LDO; RICHTEK RT9193; LDO UNION UM1750S; NVCC_CSI (1.8V/3.3V); # 1.8V for CSI; 1.8V/3.3V for SIM; HIGH PSRR LDO; UNION UM1750S; LOAD SW; LDO_USB; VDD_USB_CAP USB_OTGx_PWR; USB_HOST_VBUS; VENET_3V3; NVCC_GPIO/NVCC_ENET/NVCC_LCDIF; NVCC_SD; SENSOR; CSI B2B CN; eCompass/ G-sensor/Gyroscope; USB_OTG_VBUS; Camera; Micron MT25QL256; QSPI; Micron MT29F32G08; NAND; OVP; NVCC_NAND; DCDC_3V3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

i.MX6ULL EVK PWR TREE

DC/DC BUCK
MPS MP2144

MPS MP2159

# 1.8V for eMMC HS200 mode

LDO SILICON IMAGE SiI9022A

# i.MX6ULL PWR

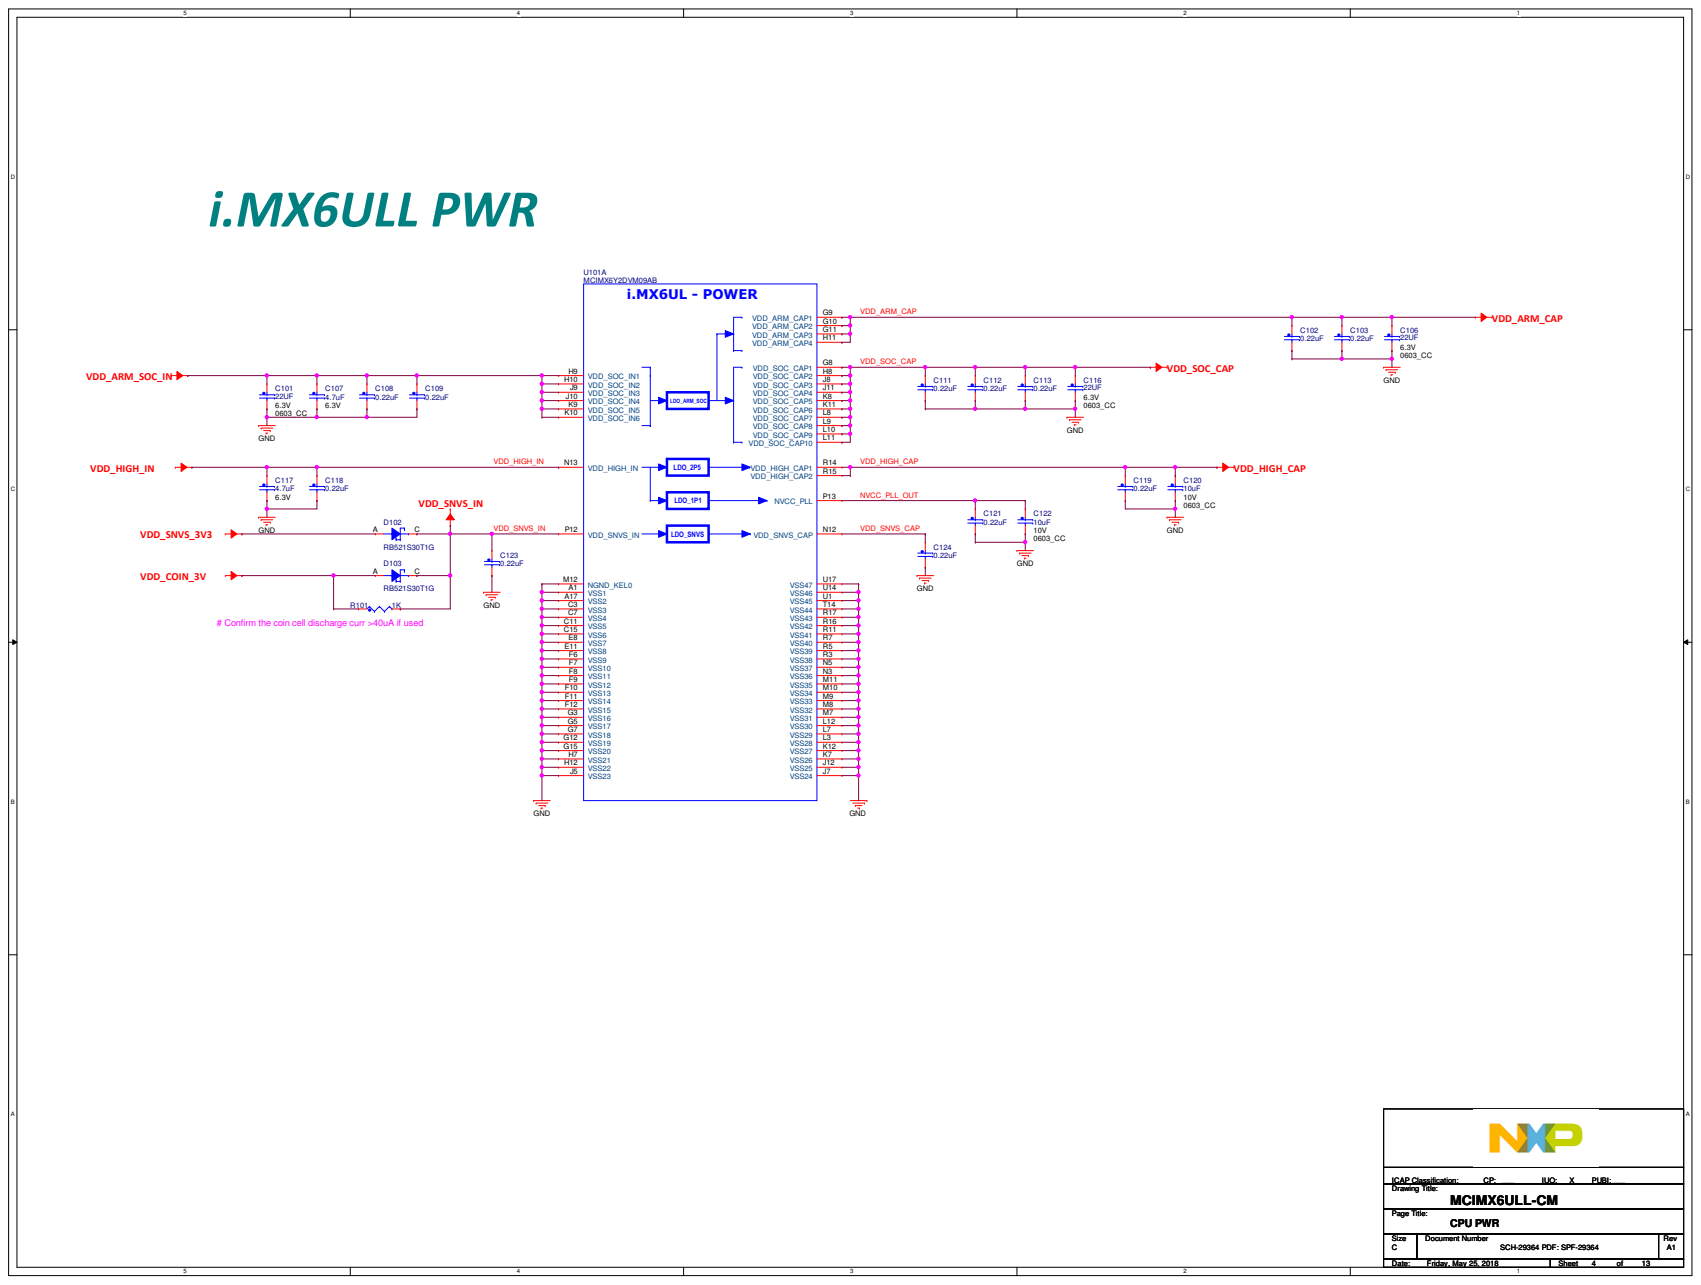
[picture p17: page 4]

# Confirm the coin cell discharge curr >40uA if used

# DDR3/LvDDR3

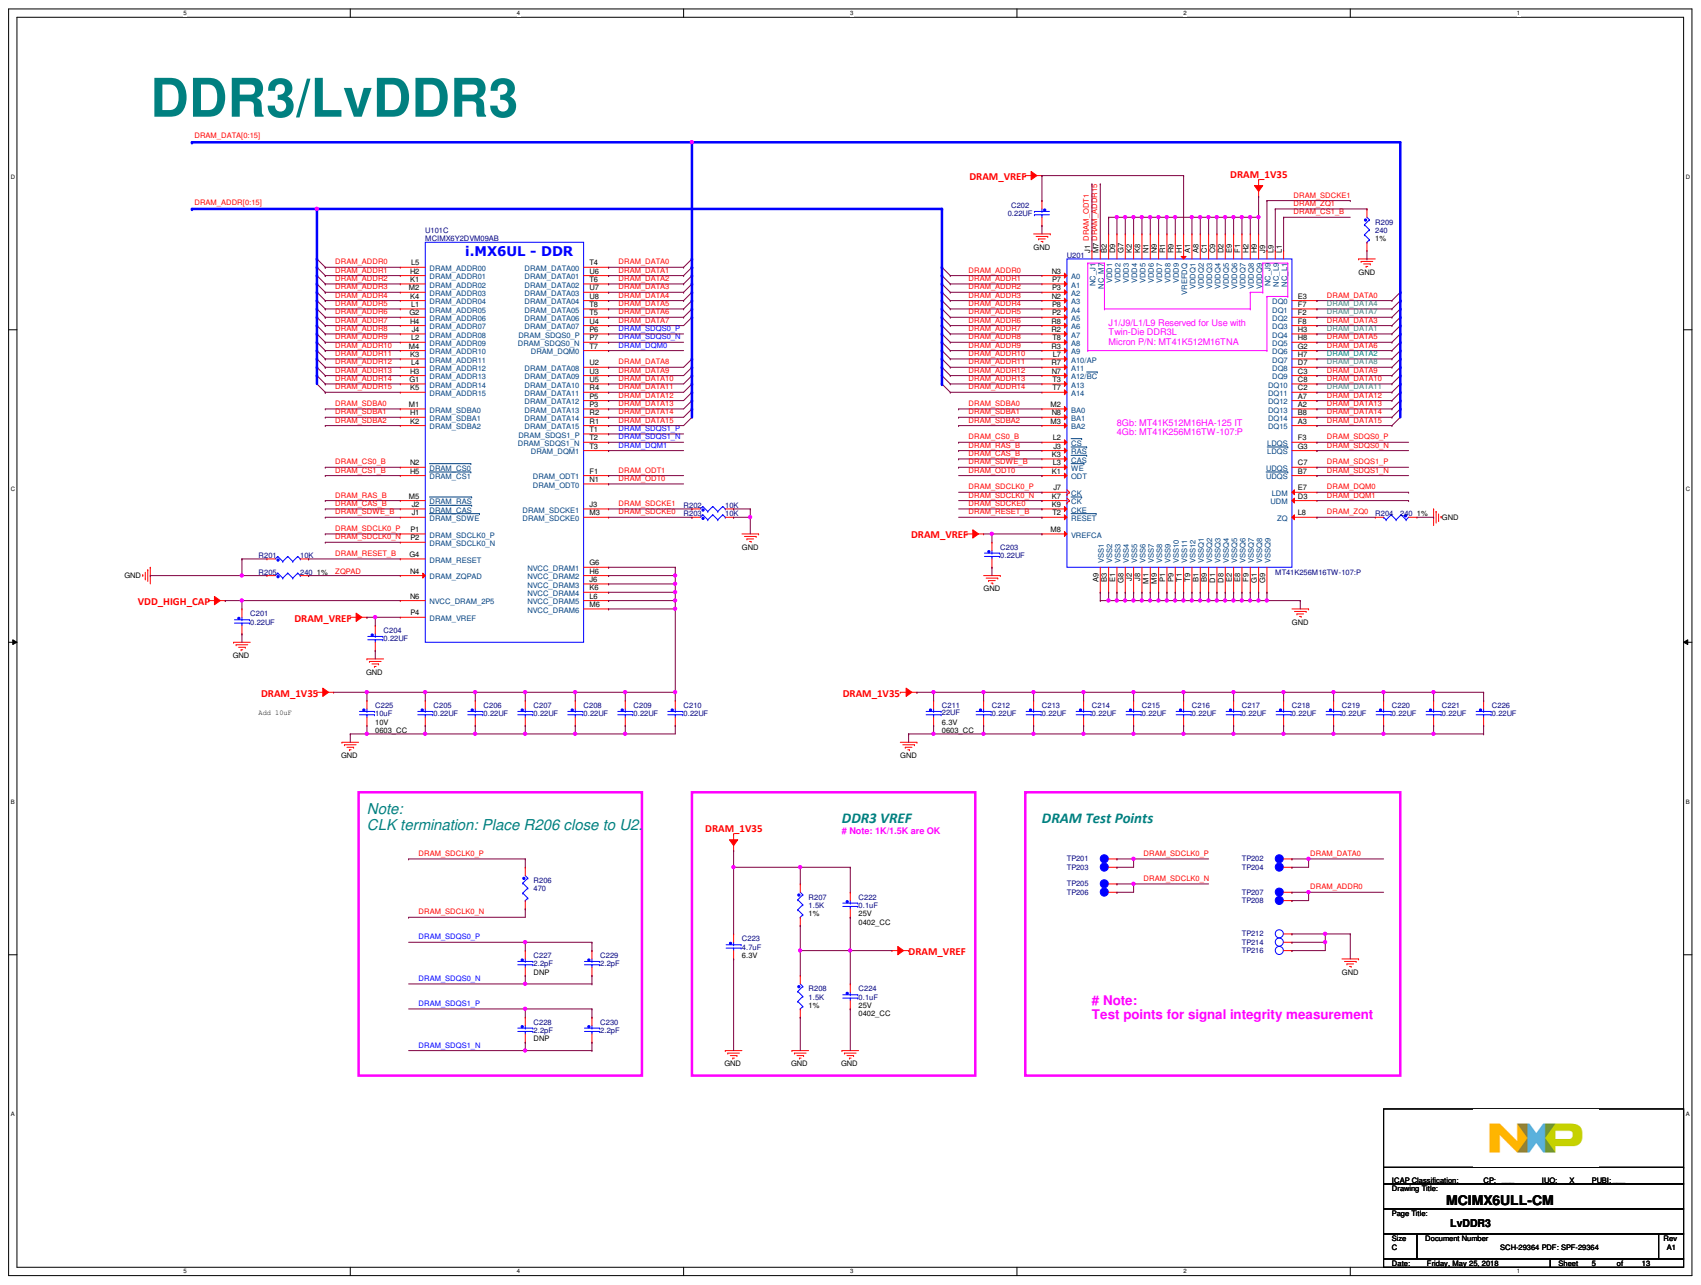
[picture p18: page 5]

J1/J9/L1/L9 Reserved for Use with
Twin-Die DDR3L
Micron P/N: MT41K512M16TNA

# Note:
Test points for signal integrity measurement

# eMMC Storage <4.51>

# Option 2 | # Option 1

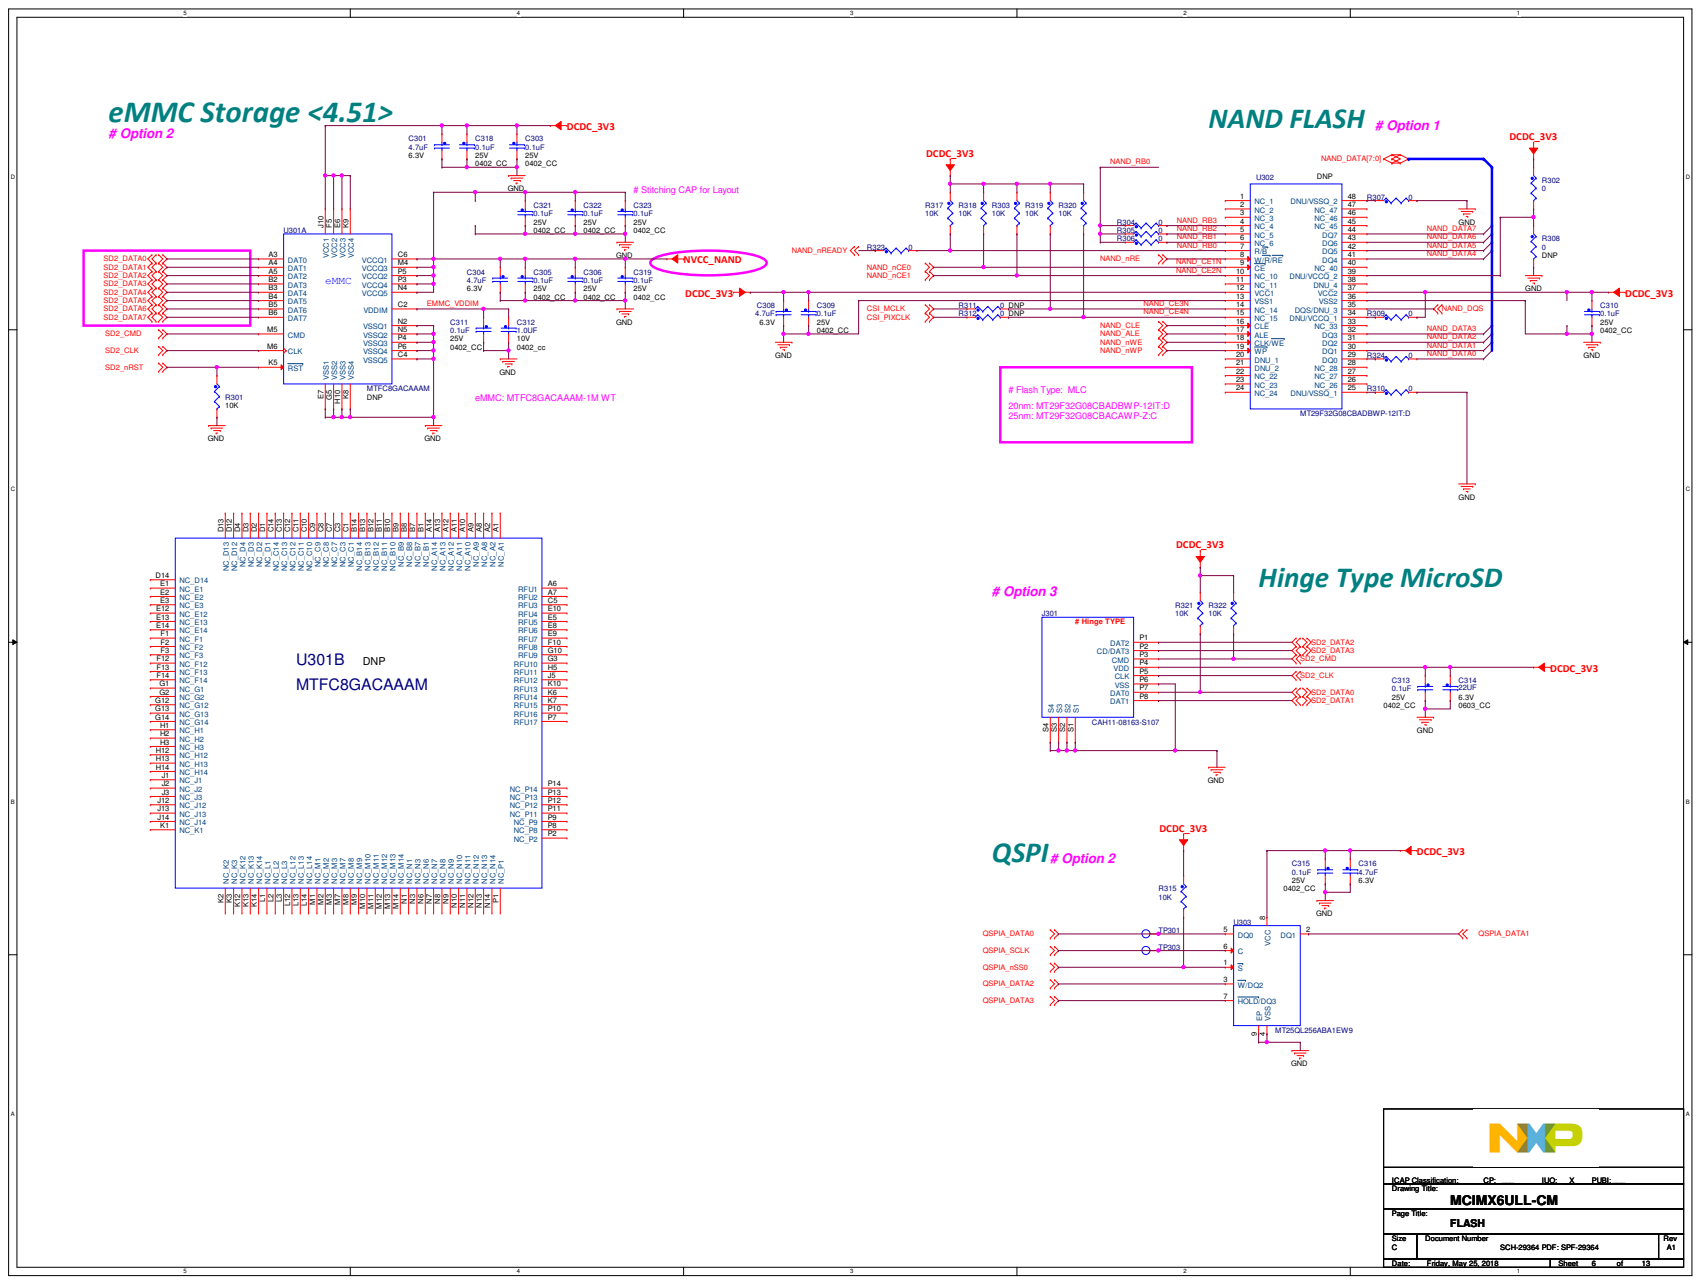
[picture p19: page 6]

# Stitching CAP for Layout

# MX6ULL PERI

## # NAND/eMMC/MicroSD/QSPI

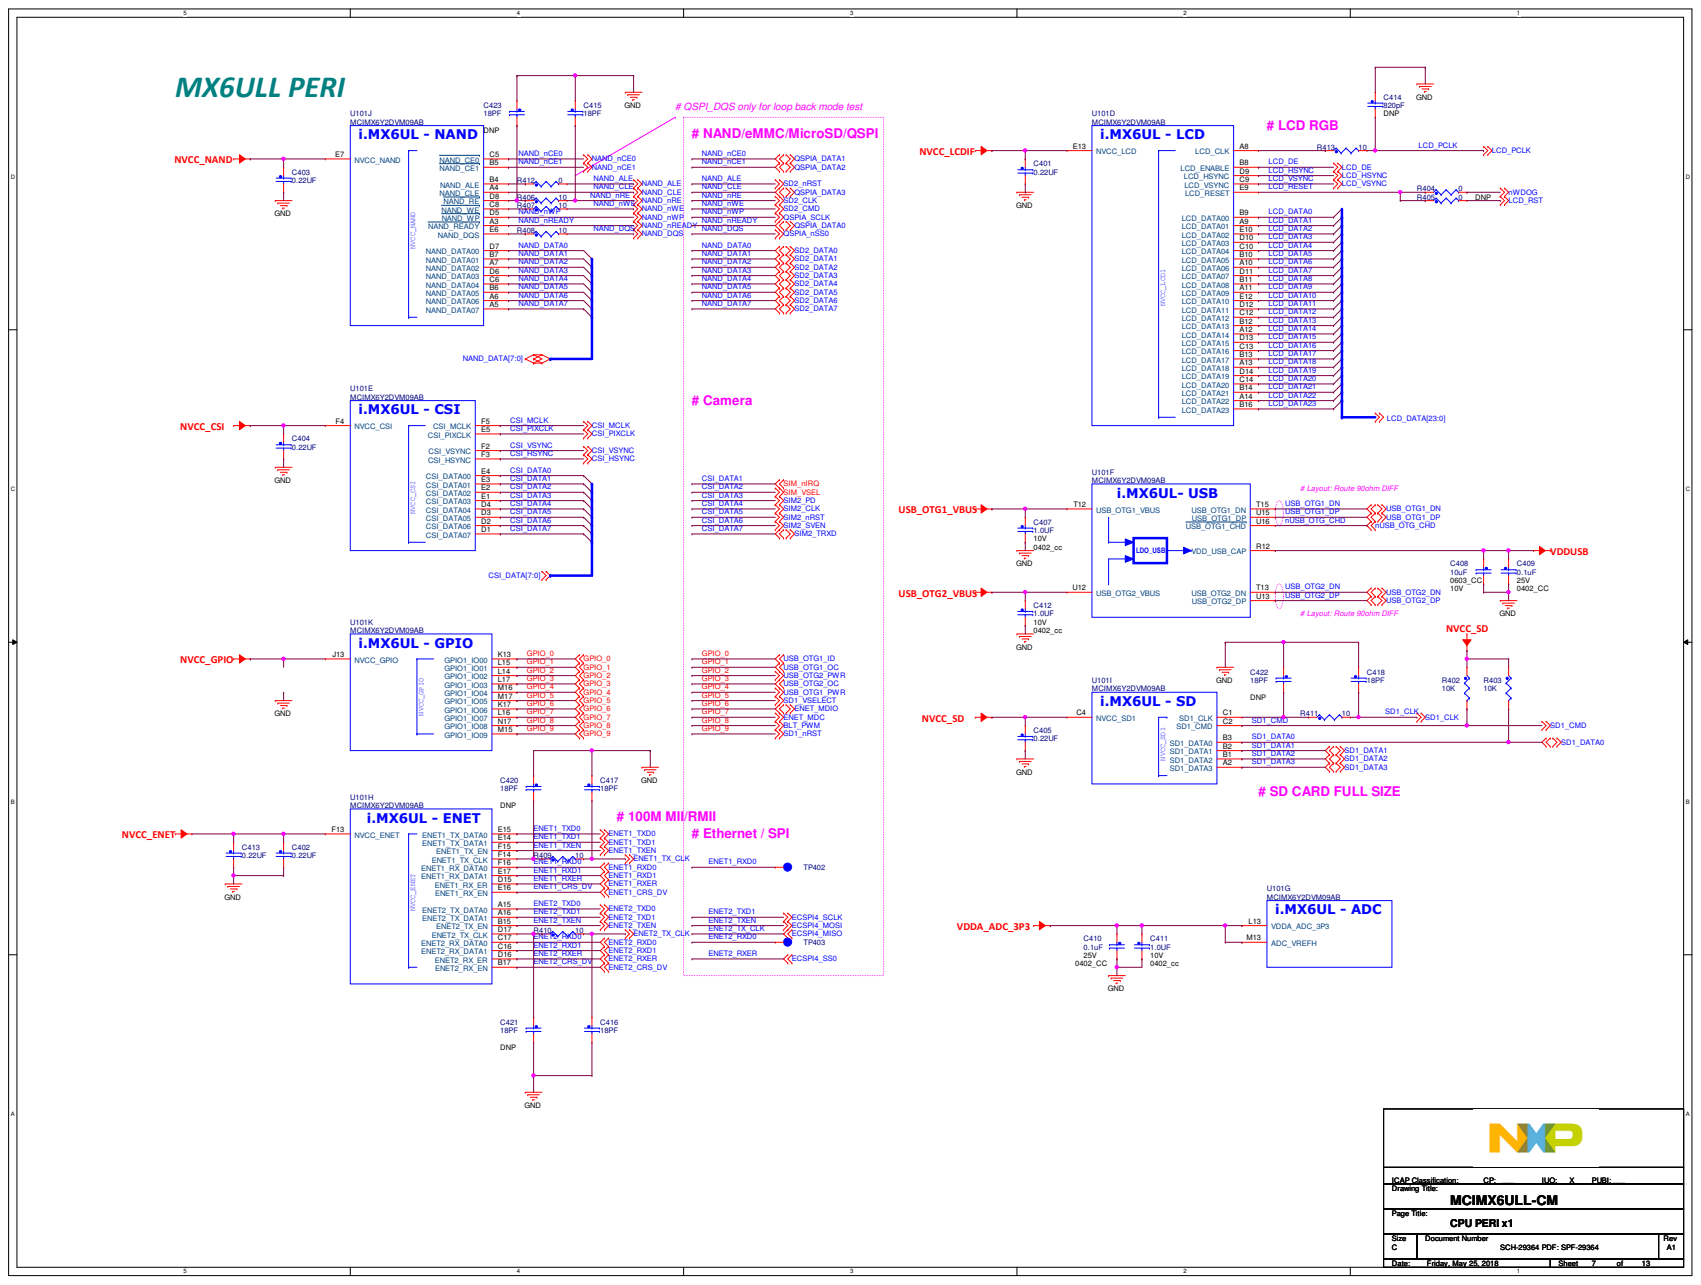
[picture p20: page 7]

# QSPI_DQS only for loop back mode test

# SD CARD FULL SIZE

# JTAG Debug

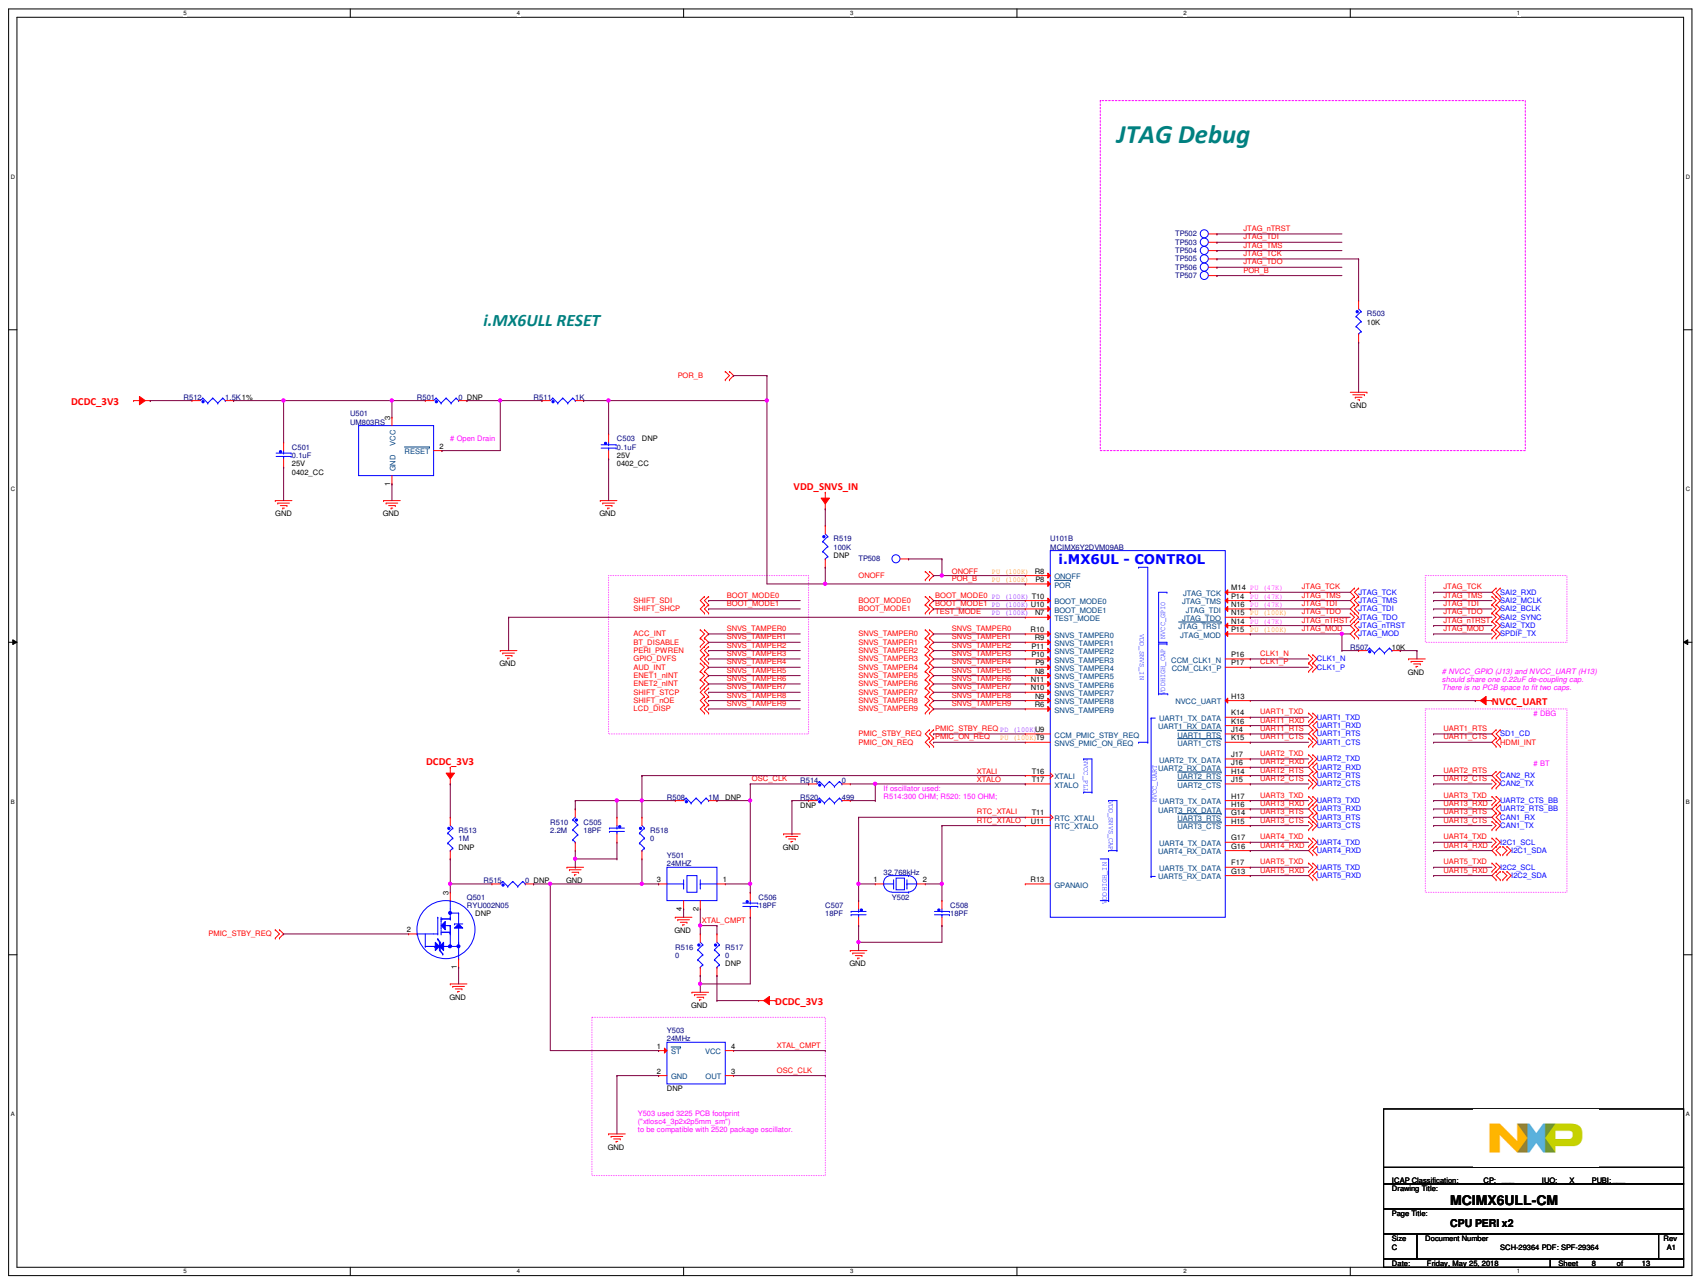
[picture p21: page 8]

# NVCC_GPIO (J13) and NVCC_UART (H13)
should share one 0.22uF de-coupling cap.
There is no PCB space to fit two caps.

Y503 used 3225 PCB footprint
("xtlosc4_3p2x2p5mm_sm")
to be compatible with 2520 package oscillator.

# Boot Configuration

## Reserved

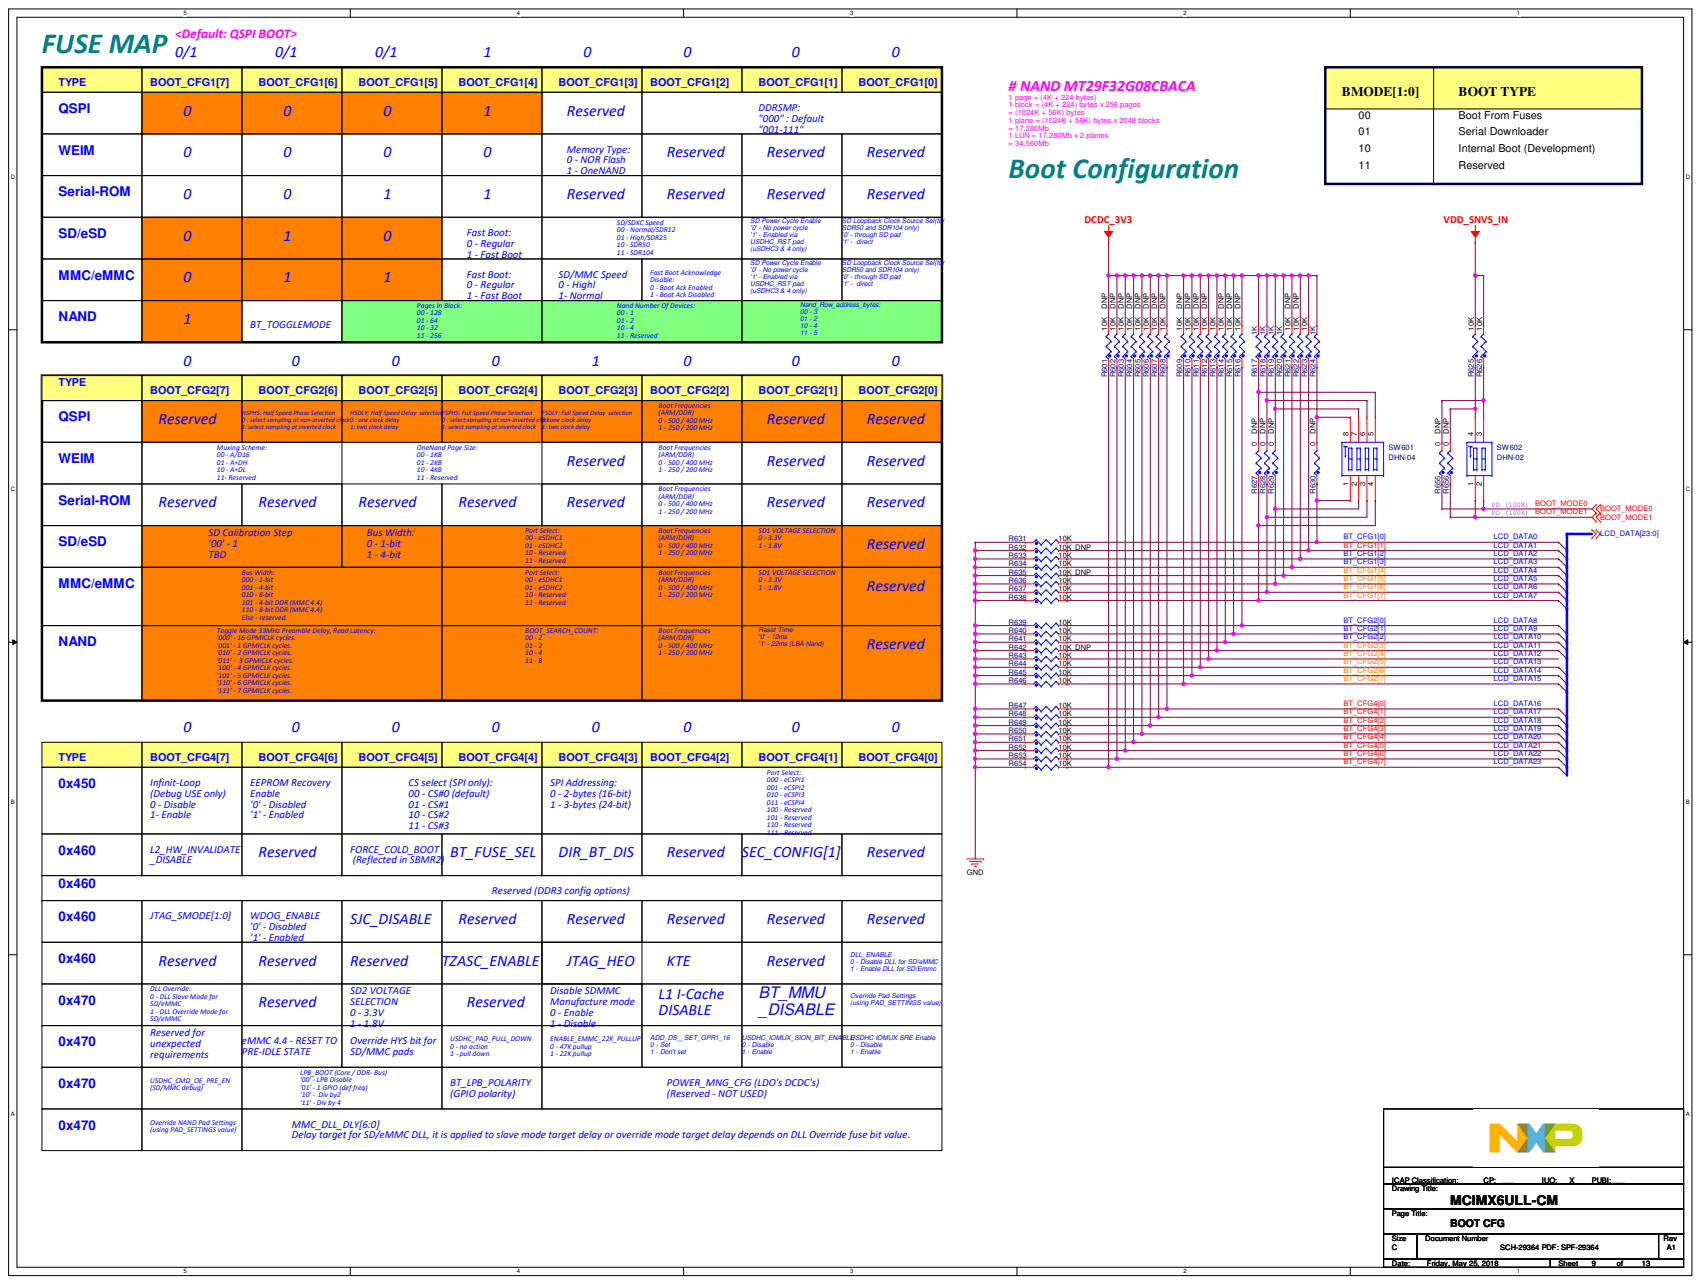
[picture p22: page 9]

FUSE MAP <Default: QSPI BOOT>

SD Power Cycle Enable
'0' - No power cycle
'1' - Enabled via
USDHC_RST pad
(uSDHC3 & 4 only)

SD Loopback Clock Source Sel(for
SDR50 and SDR104 only)
'0' - through SD pad
'1' - direct

HSDLY: Half Speed Delay selection
0 : one clock delay
1: two clock delay

FSPHS: Full Speed Phase Selection
0 : select sampling at non-inverted clock
1: select sampling at inverted clock

FSDLY: Full Speed Delay selection

Toggle Mode 33MHz Preamble Delay, Read Latency:
'000' - 16 GPMICLK cycles.
'001' - 1 GPMICLK cycles.
'010' - 2 GPMICLK cycles.
'011' - 3 GPMICLK cycles.
'100' - 4 GPMICLK cycles.
'101' - 5 GPMICLK cycles.
'110' - 6 GPMICLK cycles.
'111' - 7 GPMICLK cycles.

DLL_ENABLE
0 - Disable DLL for SD/eMMC
1 - Enable DLL for SD/Emmc

DLL Override:
0 - DLL Slave Mode for
SD/eMMC
1 - DLL Override Mode for
Reserved for
unexpected
requirements

USDHC IOMUX SRE Enable
0 - Disable
1 - Enable

Override NAND Pad Settings

# ARM/SOC

## i.MX6ULL PWR

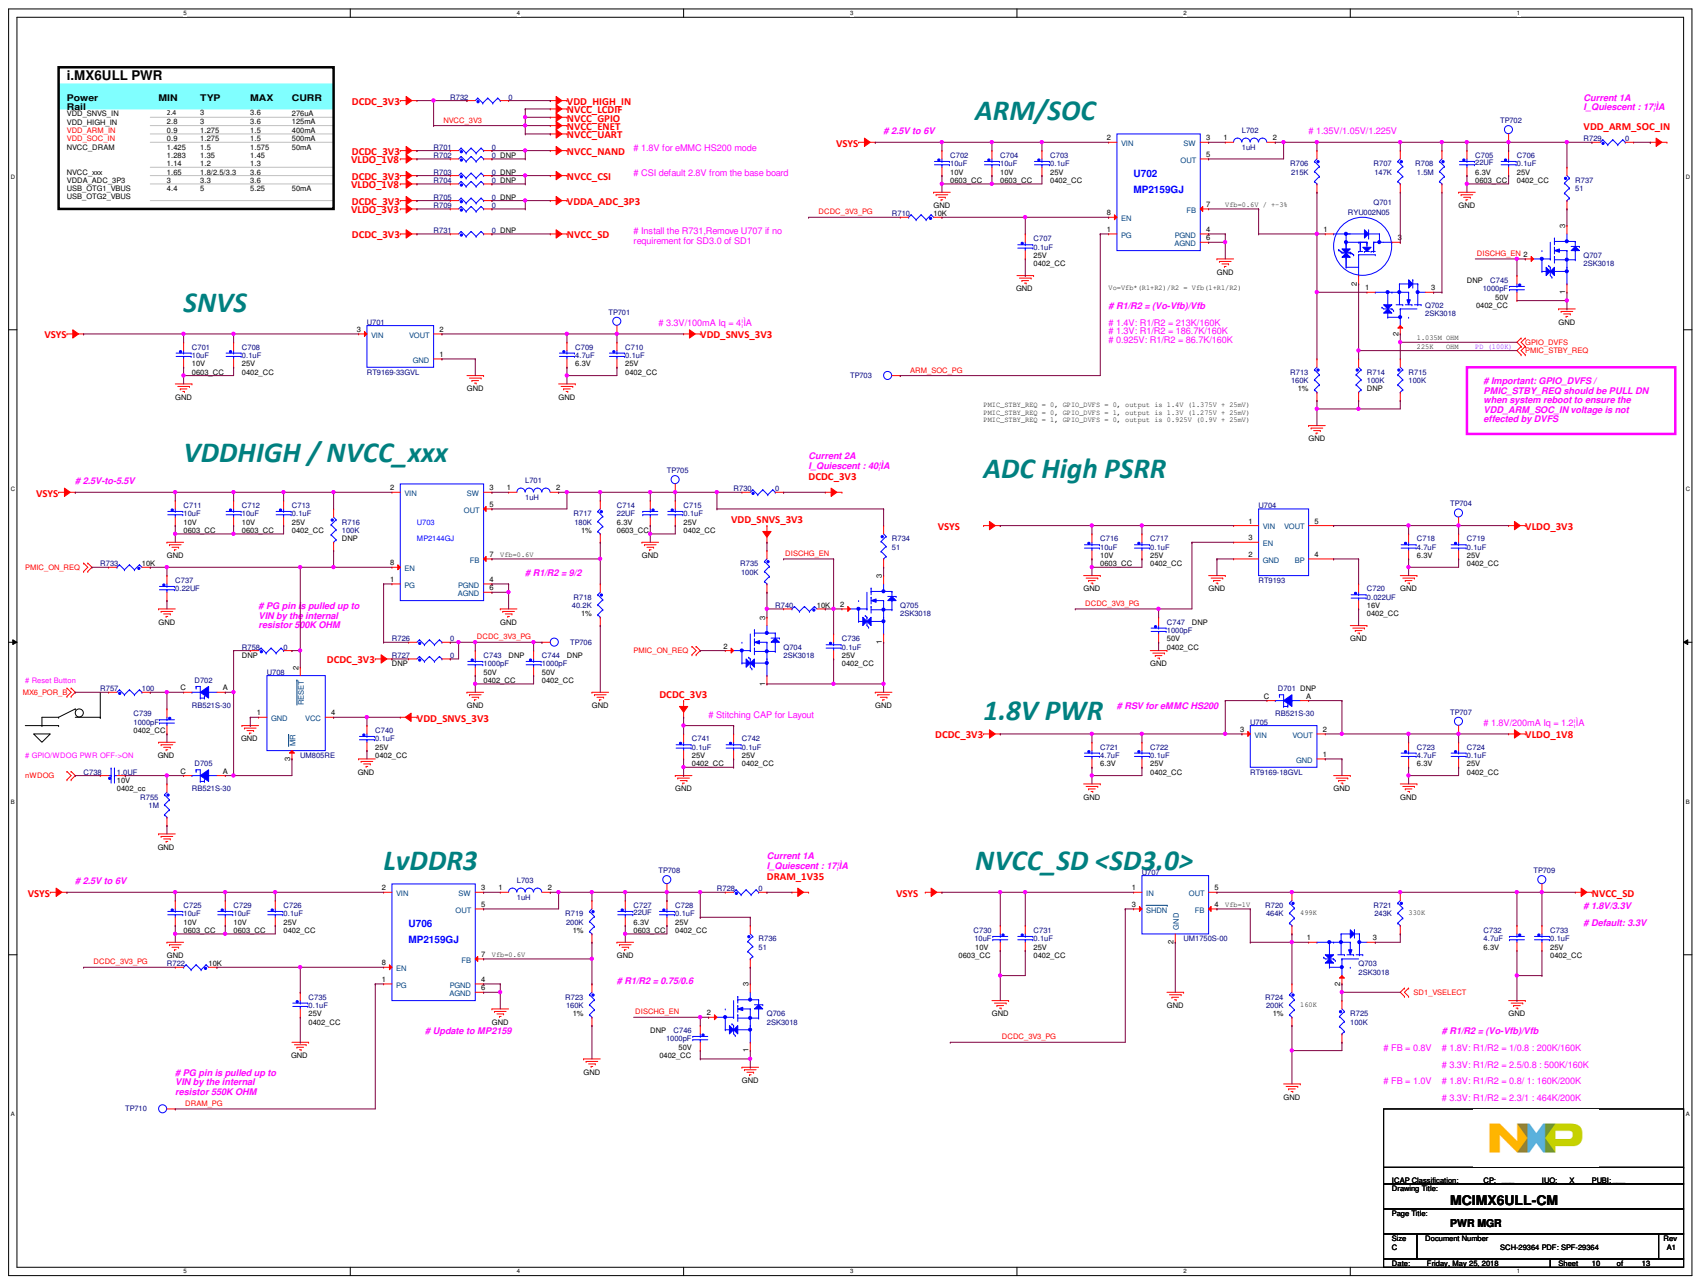
[picture p23: page 10]

# CSI default 2.8V from the base board

# Install the R731,Remove U707 if no
requirement for SD3.0 of SD1

# Important: GPIO_DVFS /
PMIC_STBY_REQ should be PULL DN
when system reboot to ensure the
VDD_ARM_SOC_IN voltage is not
effected by DVFS

# PG pin is pulled up to
VIN by the internal
resistor 500K OHM

# Stitching CAP for Layout

# GPIO/WDOG PWR OFF->ON

resistor 550K OHM
DRAM_PG

# SODIMM 200

# TP for SODIMM MFG

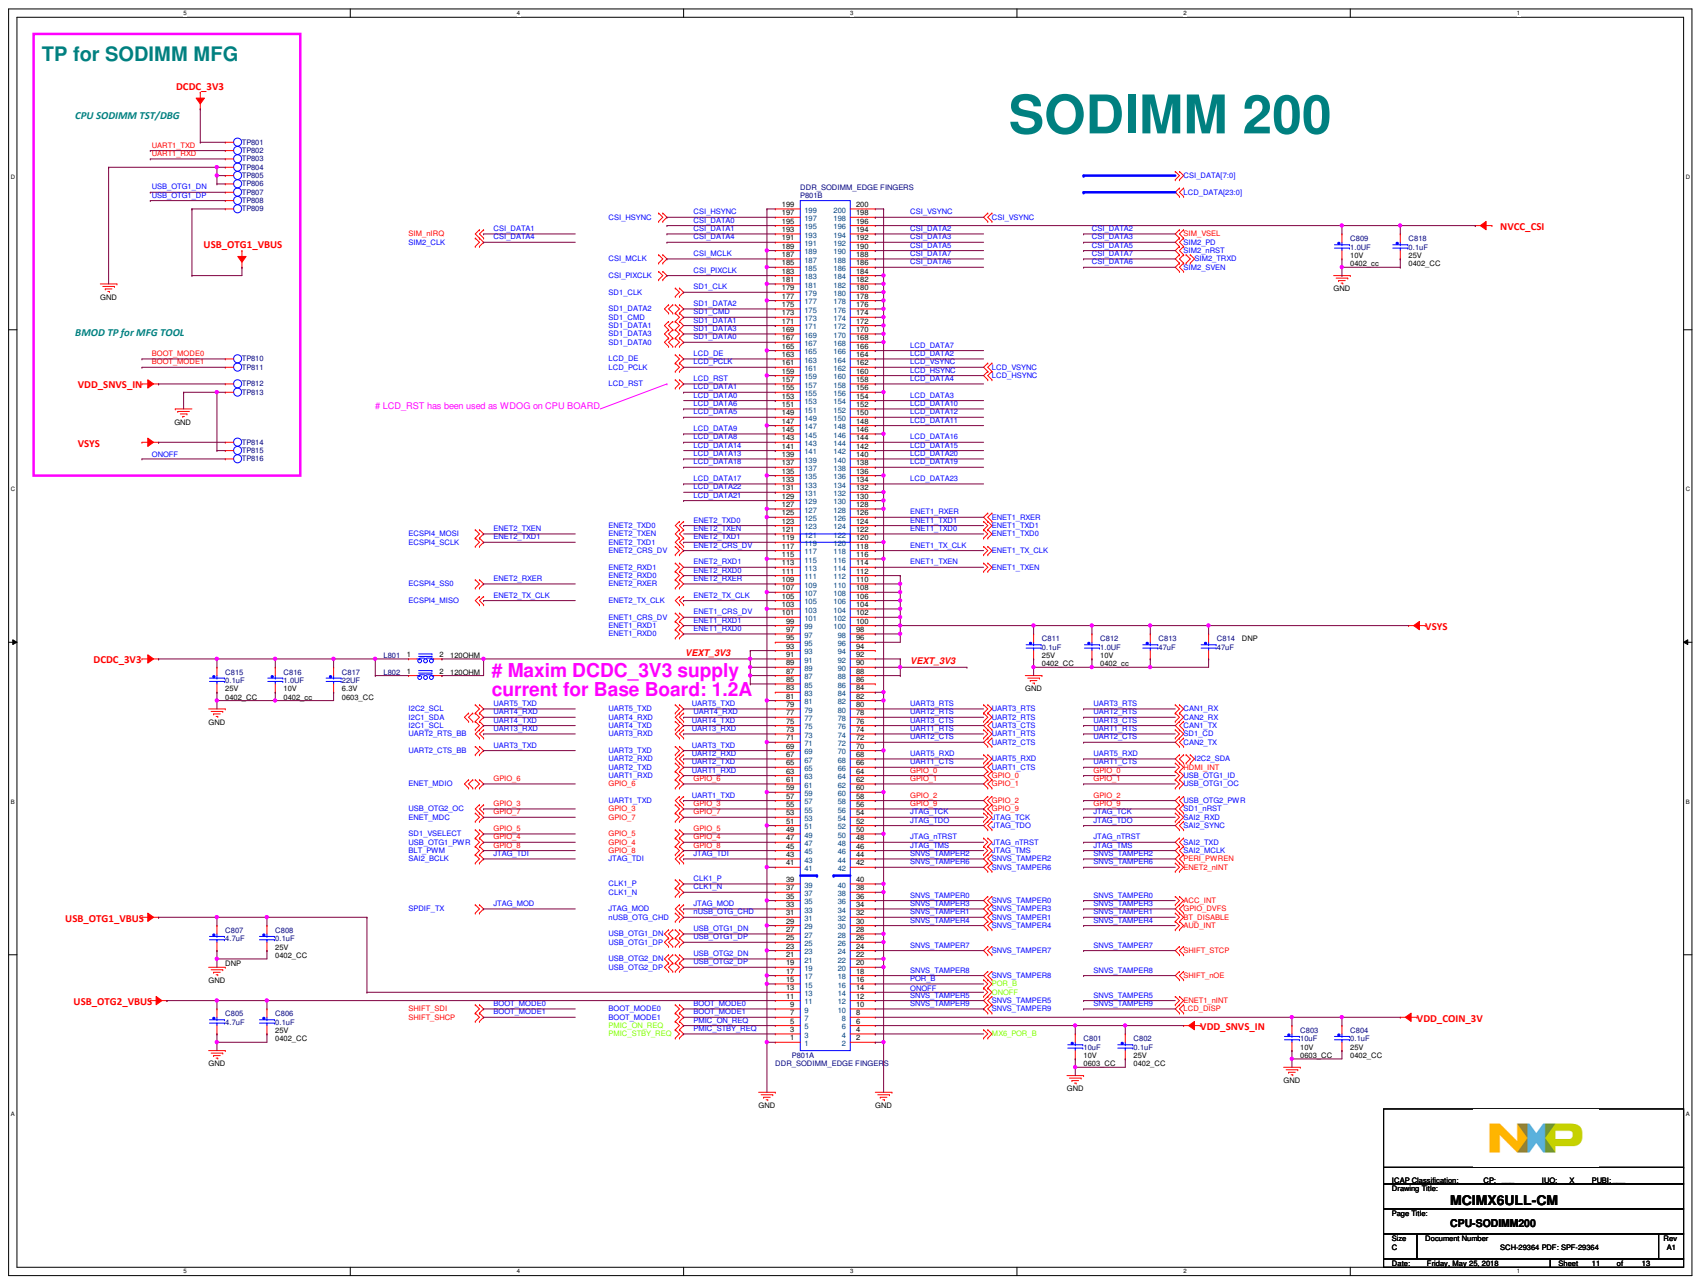
[picture p24: page 11]

CPU SODIMM TST/DBG

BMOD TP for MFG TOOL

# LCD_RST has been used as WDOG on CPU BOARD

# Maxim DCDC_3V3 supply
current for Base Board: 1.2A

D D

C C

B B

A A

# PAD

# UART3_TX_DATA

# LCD_DATA00~LCD_DATA23

# Output Buffer(LOW) during reset --> Output keeper + Input enable after reset done

# 100K pull down + input enable during reset --> Output keeper + Input enable after reset done ( this is boot option, we don¡¯ t need change)

# 0 in real silicon

# 0 in real silicon

Default State | Simulation Value

# All pins using ~reset as harden :

UART3_TX_DATA | Output Buffer(LOW) during reset --> Output keeper + Input enable after reset done | sjc.ipt_jta_active --> PAD
PAD | Default State | Signal Path | PAD Simulation Value
| | (note : sjc.ipt_jta_active also connected to snvs_hp.sec_vio_in_1. This is security related, we don¡¯ t plan to change it.) | 0 in real silicon ALT7

# PAD

# GPIO1_IO03

# GPIO1_IO03

# 100K pull down + input enable during reset --> Output keeper + Input enable after reset done

# 100K pull down + input enable during reset --> Output keeper + Input enable after reset done

# 0 in real silicon

Default State | Simulation Value

# All pins using ~src.en_system_clk as harden :

# PAD --> ccmsrcmix. src_tester_ack

PAD | Default State | Signal Path | PAD Simulation Value
| | This is the requirement of TE test | 0 in real silicon ALT7

# PAD

CSI_PIXCLK | Output keeper + Input enable (snvs_sec_vio_in_5_en is 1¡¯ b0 in normal state, so harden is not triggerd in normal state). snvs_sec_vio_in_5_en is controlled by SNVS register. It can be disable or enable.

# X (0 or 1 in real silicon )

Default State | Simulation Value

# All pins using snvs_hp.snvs_sec_vio_in_5_en as harden :

# NOTE:

Drawing Title:

Size | Document Number | Rev

Page Title:

ICAP Classification: | CP: | IUO: | PUBI:
SCH-29364 PDF: SPF-29364 | A1

## MCIMX6ULL-CM

C

### NOTE

12 | 13 ___ | ___ _X_ Drawing Title: Size | Document Number | Rev Date: | Sheet | of Page Title: ICAP Classification: | CP: | IUO: | PUBI: SCH-29364 PDF: SPF-29364 | A1 MCIMX6ULL-CM C | Friday, May 25, 2018 NOTE | 12 | 13 ___ | ___ _X_ Drawing Title: Size | Document Number | Rev Date: | Sheet | of Page Title: ICAP Classification: | CP: | IUO: | PUBI: SCH-29364 PDF: SPF-29364 | A1 MCIMX6ULL-CM C | Friday, May 25, 2018 NOTE | 12 | 13 ___ | ___ _X_

# i.MX6ULL IOMUX

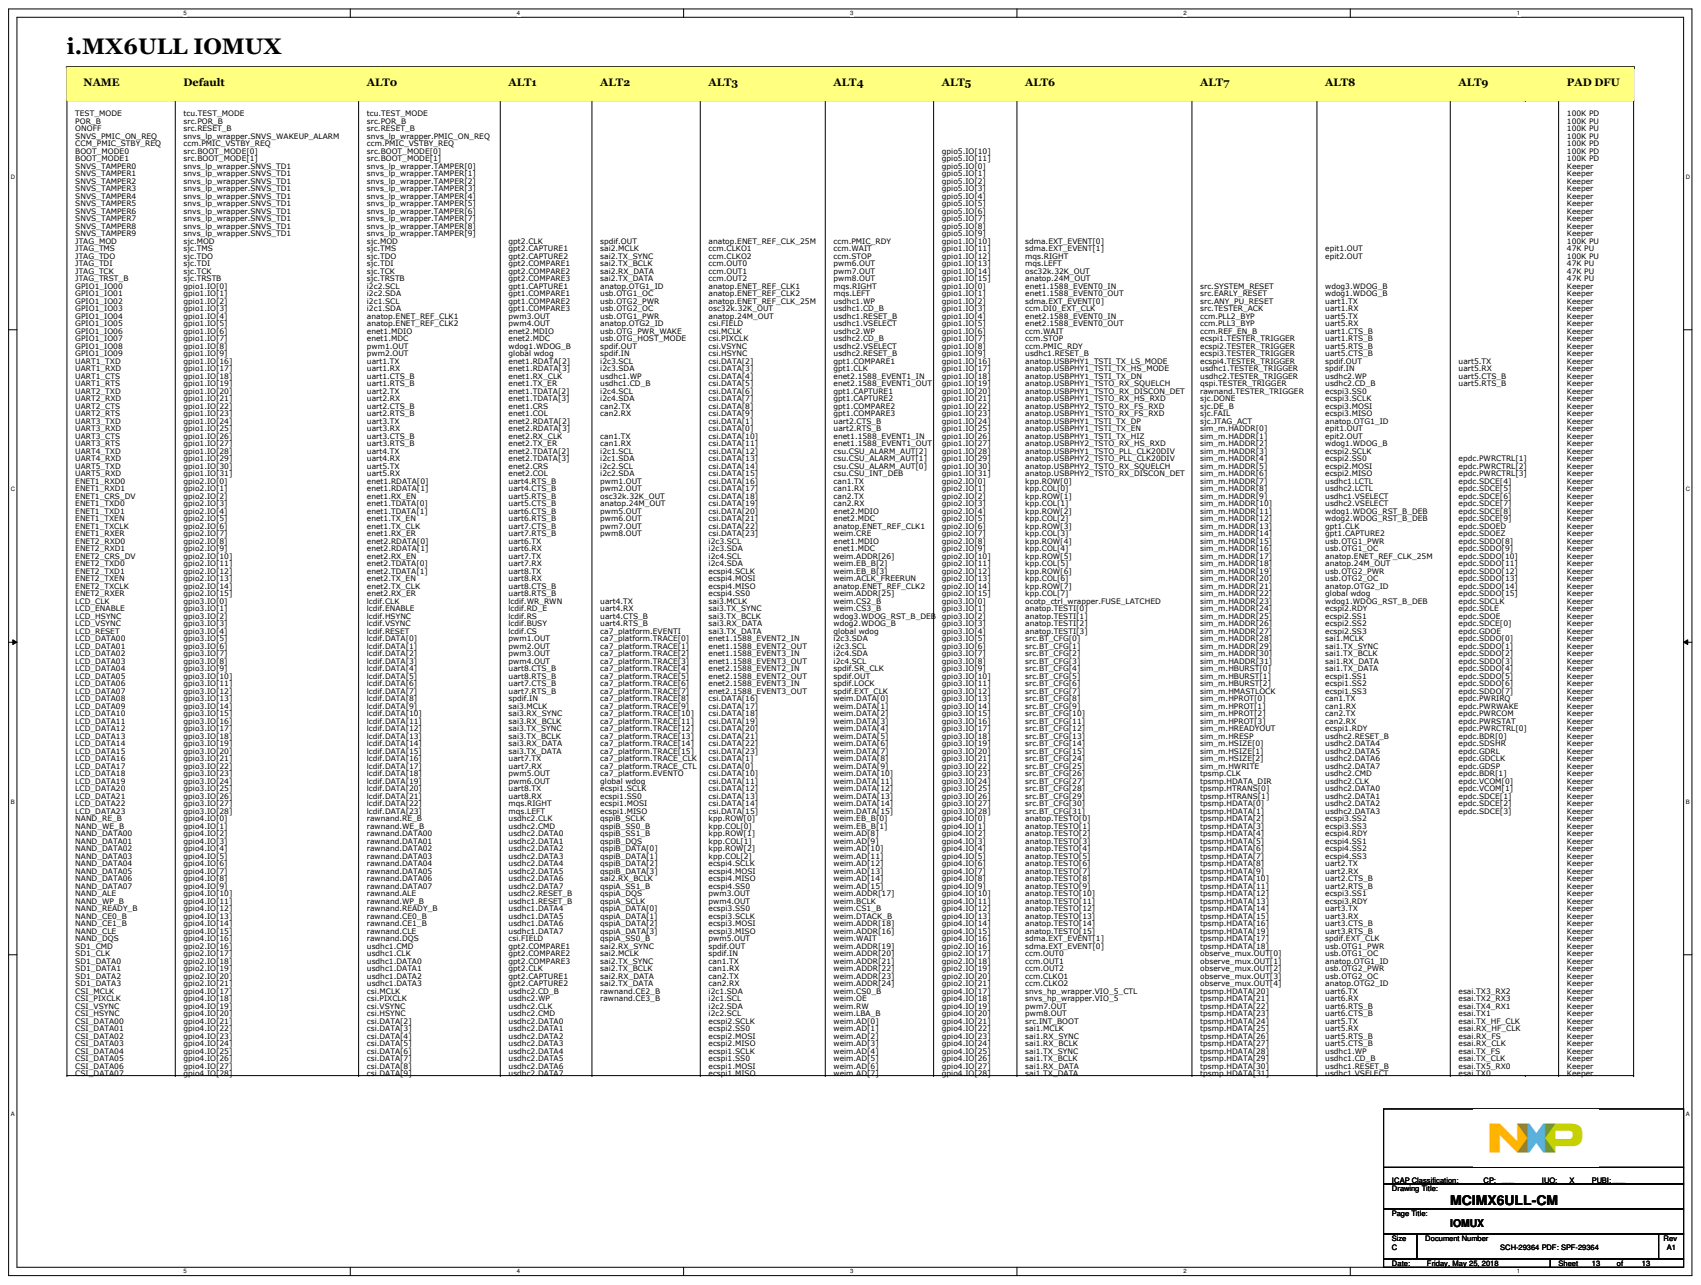
[picture p25: page 13]
uart5.TX uart5.RX uart5.CTS_B uart5.RTS_B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
