owenosborn/imx6ulz-brain/kicad/EX-PCB-10108-001.kicad_pcb

## KiCad design kicad/EX-PCB-10108-001.kicad_pcb (2022-12-26)

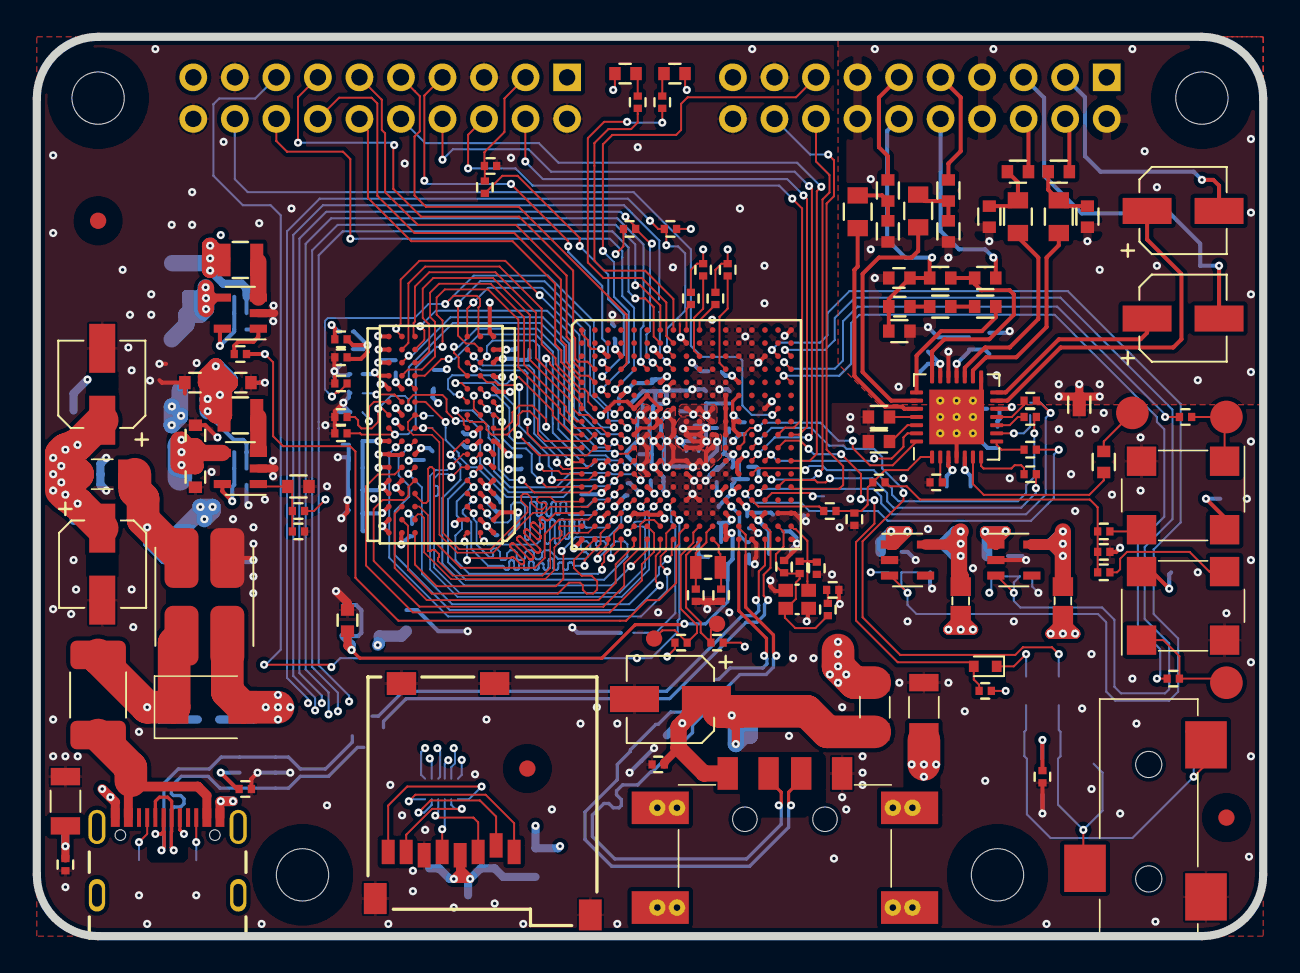
[picture p26: board EX-PCB-10108-001.kicad_pcb from above]

Board: 4 copper layers, 75.0 x 55.0 mm, 248 parts (0 on the bottom side), 203 nets.

Parts:
C1, C4, C5, C7, C16, C21, C22, C25, C26, C27, C28, C31, C301, C314, C319, C407, C414, C520, C521, C701, C702, C707, C708, C709, C710: PV-EC-CAP-017-22U; 0603
C2, C3, C6, C46, C47: PV-EC-ALU-004-100U; 5.5x5.5x5
C10, C11: PV-EC-CAP-014-8P; 0402
C12, C13, C23, C30, C52, C54, C66, C705, C706: PV-EC-CAP-014-18P; 0402
C14, C15, C24, C302, C303: PV-EC-CAP-010-4U7; 0402
C17: PV-EC-CAP-022-10N; 0603
C18, C19, C65: PV-EC-CAP-022-220N; 0603
C20, C29, C32, C33, C34, C36, C38, C39, C44, C45, C50, C53, C57, C58, C59, C304, C305, C306, C307, C308, C309, C310, C311, C312, C315, C317, C318, C401, C402, C403, C406, C408, C409, C411, C415, C416, C417, C418, C419, C420, C421, C422, C423, C424, C425, C426, C427, C501, C503, C507, C509: PV-EC-CAP-011-220N; 0402
C35, C37, C42, C43, C51, C313, C316: PV-EC-CAP-017-10U; 0603
C40, C41, C48, C49: PV-EC-CAP-029-10U; 0805
C55: PV-EC-CAP-020-1U; 0603
C56: PV-EC-CAP-022-220P; 0603
C62: PV-EC-CAP-034-10N; 1206
C63, C64: PV-EC-CAP-022-1N; 0603
CN1, CN3: PV-EC-CON-008-014; PinHeader_2x10_P2.54mm_Vertical
CN2: PV-EC-CON-013-006; 2908-05WB-MG
CN4: PV-EC-CON-010-010; USB4105-GF-A
CN5: PV-EC-CON-012-003; 35RASMT2BHNTRX
CN6: PV-EC-CON-010-004; 629104190121
D1: PV-EC-OPT-006-003; 0603
D2: PV-EC-OPT-006-002; 0603
D3: PV-EC-DIO-001-001; SOD-523
D4: PV-EC-PTN-003-012; DO-214AA-2
F1: PV-EC-PTN-005-006; 1812
FB1, FB2, FB3, FB4, FB5, FB9: PV-EC-FIL-004-002; 1206
FB6, FB7, FB8, FB10, FB11: PV-EC-FIL-004-001; 0603_FB
FID801, FID802, FID803, FID804, FID805, FID806: PV-EC-BRD-003-001; Fiducial_1mm
L1, L3: PV-EC-FIL-006-002; DLW21H
L2: PV-EC-FIL-006-003; CM2021Y330R-10
L701, L702: PV-EC-IND-010-2U2; 1008
MH1, MH2, MH3, MH4: PV-EC-BRD-007-005; MH_3.2_M3
R1, R2, R5, R9, R11, R13, R14, R23, R49, R50, R51, R52, R53, R54, R57, R504, R508, R509: PV-EC-RES-007-10K; 0402
R3: PV-EC-RES-007-3R3; 0402
R4: PV-EC-RES-010-100K; 0603
R6, R7, R8, R45: PV-EC-RES-007-1M; 0402
R10: PV-EC-RES-007-0R; 0402
R12, R24, R25, R26, R32, R34, R35, R36, R39, R43, R55, R56: PV-EC-RES-007-33R; 0402
R15, R16, R17, R18: PV-EC-RES-010-5K6; 0603
R19, R20, R21, R22, R29, R30, R42: PV-EC-RES-010-47K; 0603
R27, R28, R33: PV-EC-RES-010-100R; 0603
R31, R41: PV-EC-RES-010-0R; 0603
R37, R38: PV-EC-RES-010-150R; 0603
R40: PV-EC-RES-010-680R; 0603
R44, R48: PV-EC-RES-007-1K; 0402
R46, R47: PV-EC-RES-010-5K11; 0603
R58, R59: PV-EC-RES-007-1K5; 0402
R301, R302: PV-EC-RES-007-100K; 0402
R402, R406, R407: PV-EC-RES-007-240R; 0402
R403: PV-EC-RES-007-470R; 0402
R701: PV-EC-RES-007-453K; 0402
R703: PV-EC-RES-007-147K; 0402
TP1, TP3, TP6: PV-EC-BRD-004-1MM; TP_10
TP2, TP4, TP5, TP7, TP8: PV-EC-BRD-004-2MM; TP_20
U1, U4, U504: PV-EC-PWR-008-002; SOT-23-5
U2: PV-EC-PTN-004-004; LLP-2513-13L
U3, U7, U8: PV-EC-PTN-004-001; SOT-23-6
U6: PV-EC-AIC-003-006; QFN-28-5x5-EP
U301: PV-EC-SOC-003-004; MAPBGA-289-14x14
U401: PV-EC-MEM-008-4G; FBGA_96_DDR3L_Combo
U701, U702: PV-EC-PWR-005-001; SOT-23-5
Y1: PV-EC-CLK-003-007; CRY_2x1.6
Y2: PV-EC-CLK-003-004; CRY_2x1.2
Y3: PV-EC-CLK-004-004; OSC_5x7.5x2.5
Y4: PV-EC-CLK-004-005; OSC_5x7.5x2.5

Connections:
+1.5V: C301.1, C303.1, C305.1, C306.1, C402.2, C407.1, C408.1, C409.1, C411.1, C414.1, C415.1, C417.1, C419.1, C420.1, C421.1, C422.1, C423.1, C424.1, C425.1, C426.1, C427.1, C706.1, C708.1, C710.1, L701.2, R59.2, R703.1, U301.G6, U301.H6, U301.H9, U301.H10, U301.J6, U301.J9, U301.J10, U301.K6, U301.K9, U301.K10, U301.L6, U301.M6, U401.A1, U401.A8, U401.B2, U401.C1, U401.C9, U401.D2, U401.D9, U401.E9, U401.F1, U401.G7, U401.H2, U401.H9, U401.K2, U401.K8, U401.N1, U401.N9, U401.R1, U401.R9
+3.3V: C20.1, C29.1, C53.1, C57.1, C302.1, C304.1, C501.1, C503.1, C507.1, C509.1, C705.1, C707.1, C709.1, CN1.1, CN3.1, D1.2, D2.2, FB6.2, FB7.2, FB8.2, L702.2, R1.1, R5.1, R13.1, R14.1, R49.1, R50.1, R51.1, R52.1, R53.1, R54.1, R701.1, U301.C4, U301.E7, U301.E13, U301.F4, U301.F13, U301.H13, U301.J13, U301.L13, U301.M13, U301.N13, Y3.4, Y4.4
+3.3V.LDO1.ISO: C21.1, C35.1, C37.1, C38.1, C39.1, C42.1, C44.1, FB7.1, U1.5, U6.3, U6.5, U6.12
+3.3V.LDO2.ISO: C28.1, C43.1, C45.1, FB8.1, U4.5, U6.18
+3.3V.SNVS: C307.1, C521.1, R23.2, R57.2, U301.P12, U504.5
+5V: C1.1, C2.1, C3.1, C4.1, C5.1, C18.1, C27.1, C33.1, C34.1, C520.1, CN1.19, CN3.19, FB1.1, FB2.1, FB3.1, FB4.1, U1.1, U4.1, U301.T12, U301.U12, U504.1, U504.3
/Block_Diagram/Audio Codec/44k.EN: R43.2, U301.E17
/Block_Diagram/Audio Codec/48k.EN: R35.1, U301.D17
/Block_Diagram/Audio Codec/ADC.IN.L: CN1.11, R17.1
/Block_Diagram/Audio Codec/ADC.IN.R: CN1.9, R15.1
/Block_Diagram/Audio Codec/CSB: R29.1, U6.26
/Block_Diagram/Audio Codec/DAC.OUT.L: CN1.4, R27.2
/Block_Diagram/Audio Codec/DAC.OUT.R: CN1.6, R28.2
/Block_Diagram/Audio Codec/HP.OUT.L: C46.2, CN1.3, R21.1
/Block_Diagram/Audio Codec/HP.OUT.R: C47.2, CN1.5, R19.1
/Block_Diagram/Audio Codec/I2C2.SCL: U6.28, U301.K13
/Block_Diagram/Audio Codec/I2C2.SDA: U6.27, U301.L15
/Block_Diagram/Audio Codec/LHPOUT: C46.1, U6.13
/Block_Diagram/Audio Codec/LLINEIN: C41.1, U6.24
/Block_Diagram/Audio Codec/LOUT: C48.2, U6.16
/Block_Diagram/Audio Codec/MIC.BIAS: CN1.10, R41.2
/Block_Diagram/Audio Codec/MIC.IN: C55.1, C56.1, CN1.12, R40.2, R42.1
/Block_Diagram/Audio Codec/MICBIAS: R40.1, R41.1, U6.21
/Block_Diagram/Audio Codec/MICIN: R37.1, U6.22
/Block_Diagram/Audio Codec/RHPOUT: C47.1, U6.14
/Block_Diagram/Audio Codec/RLINEIN: C40.1, U6.23
/Block_Diagram/Audio Codec/ROUT: C49.2, U6.17
/Block_Diagram/Audio Codec/SAI2.BCK: R26.1, U301.N16
/Block_Diagram/Audio Codec/SAI2.LRCK: R24.1, R32.2, U301.N15
/Block_Diagram/Audio Codec/SAI2.MCLK: C66.1, R55.1, R56.2, U6.1
/Block_Diagram/Audio Codec/SAI2.RXD: R34.2, U301.M14
/Block_Diagram/Audio Codec/SAI2.TXD: R25.1, U301.N14
/Block_Diagram/CPU Periphery I/BM0: R57.1, TP1.1, U301.T10
/Block_Diagram/CPU Periphery I/BM1: R23.1, TP6.1, U301.U10
/Block_Diagram/CPU Periphery I/DBG.RXD: D3.1, FB11.1
/Block_Diagram/CPU Periphery I/DBG.TXD: FB10.1, U301.K14
/Block_Diagram/CPU Periphery I/ECSPI2.CS0: CN3.18, U301.G16
/Block_Diagram/CPU Periphery I/PMIC.ON.REQ: R10.1, U301.T9
/Block_Diagram/CPU Periphery I/UART2.RXD: CN3.6, U301.J16
/Block_Diagram/CPU Periphery I/UART2.TXD: CN3.4, U301.J17
/Block_Diagram/CPU Periphery I/XTALI: C10.1, R6.1, R8.1, U301.T16, Y1.1
/Block_Diagram/CPU Periphery I/XTALO: C11.1, R8.2, U301.T17, Y1.2
/Block_Diagram/CPU Periphery I/~ONOFF: CN3.15, U301.R8
/Block_Diagram/CPU Periphery I/~POR: C14.1, TP3.1, U301.P8
/Block_Diagram/CPU Periphery II/GPIO1: CN1.16, U301.M15
/Block_Diagram/CPU Periphery II/GPIO2: CN1.18, U301.N17
/Block_Diagram/CPU Periphery II/GPIO3: CN1.15, U301.F3
/Block_Diagram/CPU Periphery II/I2C1.SCL: CN3.8, U301.L14
/Block_Diagram/CPU Periphery II/I2C1.SDA: CN3.10, U301.L17
/Block_Diagram/CPU Periphery II/LDO1.EN: R1.2, R2.1, U1.3, U301.C17
/Block_Diagram/CPU Periphery II/LDO2.EN: R5.2, R9.1, U4.3, U301.C16
/Block_Diagram/CPU Periphery II/SAI1.BCK: CN3.7, U301.D3
/Block_Diagram/CPU Periphery II/SAI1.LRCK: CN3.9, U301.D4
/Block_Diagram/CPU Periphery II/SAI1.MCLK: C30.1, CN3.3, R12.2
/Block_Diagram/CPU Periphery II/SAI1.RXD: CN3.13, U301.D2
/Block_Diagram/CPU Periphery II/SAI1.TXD: CN3.11, U301.D1
/Block_Diagram/CPU Periphery II/USB1_N: L3.4, U301.T15
/Block_Diagram/CPU Periphery II/USB1_P: L3.1, U301.U15
/Block_Diagram/CPU Periphery II/USB2_N: L1.4, U301.T13
/Block_Diagram/CPU Periphery II/USB2_P: L1.1, U301.U13
/Block_Diagram/CPU Periphery II/~LED.GREEN: R48.2, U301.B8
/Block_Diagram/CPU Periphery II/~LED.RED: R44.1, U301.A8
/Block_Diagram/CPU Power/NVCC_PLL_OUT: C311.1, C313.1, U301.P13
/Block_Diagram/CPU Power/VDD.HIGH.CAP: C315.1, C316.1, C401.1, U301.N6, U301.R14, U301.R15
/Block_Diagram/CPU Power/VDD_ARM_CAP: C317.1, C318.1, C319.1, U301.G9, U301.G10, U301.G11, U301.H11
/Block_Diagram/CPU Power/VDD_SNVS_CAP: C309.1, U301.N12
/Block_Diagram/CPU Power/VDD_SOC_CAP: C308.1, C310.1, C312.1, C314.1, U301.G8, U301.H8, U301.J8, U301.J11, U301.K8, U301.K11, U301.L8, U301.L9, U301.L10, U301.L11
/Block_Diagram/Connector/5V.F: C19.1, FB1.2, L2.4
/Block_Diagram/Connector/5V.UNF: C65.1, D4.1, F1.1, L2.1
/Block_Diagram/Connector/5V.USBA: C6.1, C7.1, C17.1, C36.1, CN6.1, FB3.2, U3.5
/Block_Diagram/Connector/DBG.RX: C64.1, CN5.4, FB11.2, TP8.1, U8.3, U8.4
/Block_Diagram/Connector/DBG.TX: C63.1, CN5.1, FB10.2, TP7.1, U8.1, U8.6
/Block_Diagram/Connector/GND.UNF: C65.2, CN4.A1B12, CN4.B1A12, D4.2, L2.2
/Block_Diagram/Connector/SD2.CLK: C23.2, R3.2, U2.4
/Block_Diagram/Connector/SD2.CMD: R54.2, U2.3, U301.C8
/Block_Diagram/Connector/SD2.D0: R53.2, U2.5, U301.D7
/Block_Diagram/Connector/SD2.D1: U2.6, U301.B7
/Block_Diagram/Connector/SD2.D2: U2.1, U301.A7
/Block_Diagram/Connector/SD2.D3: U2.2, U301.D6
/Block_Diagram/Connector/SD.VCC: C24.1, C25.1, C26.1, CN2.P4, FB6.1
/Block_Diagram/Connector/USB1F_N: CN4.A7, CN4.B7, L3.3, U7.3, U7.4
/Block_Diagram/Connector/USB1F_P: CN4.A6, CN4.B6, L3.2, U7.1, U7.6
/Block_Diagram/Connector/USB2F_N: CN6.2, L1.3, U3.1, U3.6
/Block_Diagram/Connector/USB2F_P: CN6.3, L1.2, U3.3, U3.4
/Block_Diagram/DRAM/DRAM_ADDR0: U301.L5, U401.N3
/Block_Diagram/DRAM/DRAM_ADDR1: U301.H2, U401.P7
/Block_Diagram/DRAM/DRAM_ADDR2: U301.K1, U401.P3
/Block_Diagram/DRAM/DRAM_ADDR3: U301.M2, U401.N2
/Block_Diagram/DRAM/DRAM_ADDR4: U301.K4, U401.P8
/Block_Diagram/DRAM/DRAM_ADDR5: U301.L1, U401.P2
/Block_Diagram/DRAM/DRAM_ADDR6: U301.G2, U401.R8
/Block_Diagram/DRAM/DRAM_ADDR7: U301.H4, U401.R2
/Block_Diagram/DRAM/DRAM_ADDR8: U301.J4, U401.T8
/Block_Diagram/DRAM/DRAM_ADDR9: U301.L2, U401.R3
/Block_Diagram/DRAM/DRAM_ADDR10: U301.M4, U401.L7
/Block_Diagram/DRAM/DRAM_ADDR11: U301.K3, U401.R7
/Block_Diagram/DRAM/DRAM_ADDR12: U301.L4, U401.N7
/Block_Diagram/DRAM/DRAM_ADDR13: U301.H3, U401.T3
/Block_Diagram/DRAM/DRAM_ADDR14: U301.G1, U401.T7
/Block_Diagram/DRAM/DRAM_ADDR15: U301.K5, U401.M7
/Block_Diagram/DRAM/DRAM_CAS_B: U301.J2, U401.K3
/Block_Diagram/DRAM/DRAM_CS0_B: U301.N2, U401.L2
/Block_Diagram/DRAM/DRAM_CS1_B: U301.H5, U401.L1
/Block_Diagram/DRAM/DRAM_DATA0: U301.T4, U401.E3
/Block_Diagram/DRAM/DRAM_DATA1: U301.U6, U401.H3
/Block_Diagram/DRAM/DRAM_DATA2: U301.T6, U401.F8
/Block_Diagram/DRAM/DRAM_DATA3: U301.U7, U401.H7
/Block_Diagram/DRAM/DRAM_DATA4: U301.U8, U401.F7
/Block_Diagram/DRAM/DRAM_DATA5: U301.T8, U401.H8
/Block_Diagram/DRAM/DRAM_DATA6: U301.T5, U401.G2
/Block_Diagram/DRAM/DRAM_DATA7: U301.U4, U401.F2
/Block_Diagram/DRAM/DRAM_DATA8: U301.U2, U401.B8
/Block_Diagram/DRAM/DRAM_DATA9: U301.U3, U401.C3
/Block_Diagram/DRAM/DRAM_DATA10: U301.U5, U401.C8
/Block_Diagram/DRAM/DRAM_DATA11: U301.R4, U401.A2
/Block_Diagram/DRAM/DRAM_DATA12: U301.P5, U401.A7
/Block_Diagram/DRAM/DRAM_DATA13: U301.P3, U401.C2
/Block_Diagram/DRAM/DRAM_DATA14: U301.R2, U401.D7
/Block_Diagram/DRAM/DRAM_DATA15: U301.R1, U401.A3
/Block_Diagram/DRAM/DRAM_DQM0: U301.T7, U401.E7
/Block_Diagram/DRAM/DRAM_DQM1: U301.T3, U401.D3
/Block_Diagram/DRAM/DRAM_ODT0: U301.N1, U401.K1
/Block_Diagram/DRAM/DRAM_ODT1: U301.F1, U401.J1
/Block_Diagram/DRAM/DRAM_RAS_B: U301.M5, U401.J3
/Block_Diagram/DRAM/DRAM_RESET_B: R509.2, U301.G4, U401.T2
/Block_Diagram/DRAM/DRAM_SDBA0: U301.M1, U401.M2
/Block_Diagram/DRAM/DRAM_SDBA1: U301.H1, U401.N8
/Block_Diagram/DRAM/DRAM_SDBA2: U301.K2, U401.M3
/Block_Diagram/DRAM/DRAM_SDCKE0: R508.1, U301.M3, U401.K9
/Block_Diagram/DRAM/DRAM_SDCKE1: R504.1, U301.J3, U401.J9
/Block_Diagram/DRAM/DRAM_SDCLK0_N: R403.2, U301.P2, U401.K7
/Block_Diagram/DRAM/DRAM_SDCLK0_P: R403.1, U301.P1, U401.J7
/Block_Diagram/DRAM/DRAM_SDQS0_N: U301.P7, U401.G3
/Block_Diagram/DRAM/DRAM_SDQS0_P: U301.P6, U401.F3
/Block_Diagram/DRAM/DRAM_SDQS1_N: U301.T2, U401.B7
/Block_Diagram/DRAM/DRAM_SDQS1_P: U301.T1, U401.C7
/Block_Diagram/DRAM/DRAM_SDWE_B: U301.J1, U401.L3
/Block_Diagram/DRAM/DRAM_VREF: C402.1, C403.1, C406.1, C416.1, C418.1, R58.1, R59.1, U301.P4, U401.H1, U401.M8
/Block_Diagram/DRAM/DRAM_ZQ0: R407.2, U401.L8
/Block_Diagram/DRAM/DRAM_ZQ1: R406.2, U401.L9
/Block_Diagram/DRAM/ZQPAD: R402.2, U301.N4
/Block_Diagram/ECSPI2.MISO: CN3.12, U301.E1
/Block_Diagram/ECSPI2.MOSI: CN3.14, U301.E2
/Block_Diagram/ECSPI2.SCK: CN3.16, U301.E4
GND: C1.2, C2.2, C3.2, C4.2, C5.2, C6.2, C7.2, C10.2, C11.2, C12.2, C13.2, C14.2, C15.2, C16.2, C17.2, C18.2, C19.2, C20.2, C21.2, C22.2, C23.1, C24.2, C25.2, C26.2, C27.2, C28.2, C29.2, C30.2, C31.2, C32.2, C33.2, C34.2, C35.2, C36.2, C37.2, C38.2, C39.2, C42.2, C44.2, C52.1, C53.2, C54.1, C57.2, C58.2, C59.2, C62.2, C63.2, C64.2, C66.2, C301.2, C302.2, C303.2, C304.2, C305.2, C306.2, C307.2, C308.2, C309.2, C310.2, C311.2, C312.2, C313.2, C314.2, C315.2, C316.2, C317.2, C318.2, C319.2, C401.2, C403.2, C406.2, C407.2, C408.2, C409.2, C411.2, C414.2, C415.2, C416.2, C417.2, C418.2, C419.2, C420.2, C421.2, C422.2, C423.2, C424.2, C425.2, C426.2, C427.2, C501.2, C503.2, C507.2, C509.2, C520.2, C521.2, C701.2, C702.2, C707.2, C708.2, C709.2, C710.2, CN1.17, CN1.20, CN2.G1, CN2.G2, CN2.G3, CN2.G4, CN2.P6, CN3.2, CN3.5, CN3.17, CN3.20, CN5.5, CN6.4, FB5.2, FB9.2, L2.3, R2.2, R4.2, R7.2, R9.2, R11.1, R29.2, R30.2, R31.1, R45.2, R46.2, R47.2, R58.2, R301.2, R302.2, R402.1, R406.1, R407.1, R504.2, R508.2, R509.1, U1.2, U2.13, U3.2, U4.2, U6.4, U6.15, U6.EP, U7.2, U8.2, U301.A1, U301.A11, U301.A12, U301.A13, U301.A14, U301.A17, U301.B9, U301.B10, U301.B11, U301.B12, U301.B13, U301.B14, U301.B16, U301.C3, U301.C7, U301.C11, U301.C12, U301.C13, U301.C14, U301.C15, U301.D10, U301.D11, U301.D13, U301.D14, U301.E8, U301.E10, U301.E11, U301.E12, U301.F6, U301.F7, U301.F8, U301.F9, U301.F10, U301.F11, U301.F12, U301.G3, U301.G5, U301.G7, U301.G12, U301.G15, U301.H7, U301.H12, U301.J5, U301.J7, U301.J12, U301.K7, U301.K12, U301.L3, U301.L7, U301.L12, U301.M7, U301.M8, U301.M9, U301.M10, U301.M11, U301.M12, U301.N3, U301.N5, U301.N7, U301.N8, U301.N9, U301.N10, U301.N11, U301.P9, U301.P10, U301.P11, U301.R3, U301.R5, U301.R6, U301.R7, U301.R9, U301.R10, U301.R11, U301.R16, U301.R17, U301.T14, U301.U1, U301.U14, U301.U17, U401.A9, U401.B1, U401.B3, U401.B9, U401.D1, U401.D8, U401.E1, U401.E2, U401.E8, U401.F9, U401.G1, U401.G8, U401.G9, U401.J2, U401.J8, U401.M1, U401.M9, U401.P1, U401.P9, U401.T1, U401.T9, U504.2, U701.2, U702.2, Y1.G, Y3.2, Y4.2
GNDA: C43.2, C45.2, C50.2, C51.2, C56.2, CN1.2, CN1.7, CN1.8, CN1.13, CN1.14, R16.2, R18.2, R19.2, R20.2, R21.2, R22.2, R31.2, R42.2, U6.19
unnamed: C12.1, U301.T11, Y2.1
unnamed: C13.1, U301.U11, Y2.2
unnamed: C15.1, R4.1, R14.2, U702.1
unnamed: C16.1, C701.1, FB2.2, U701.4
unnamed: C22.1, C702.1, FB4.2, U702.4
unnamed: C31.1, C32.1, U301.R12
unnamed: C40.2, R15.2, R16.1
unnamed: C41.2, R17.2, R18.1
unnamed: C48.1, R22.1, R27.1
unnamed: C49.1, R20.1, R28.1
unnamed: C50.1, C51.1, U6.20
unnamed: C52.2, U6.2
unnamed: C54.2, R36.2, R39.1, R55.2
unnamed: C55.2, R38.2
unnamed: C58.1, U7.5
unnamed: C59.1, U8.5
unnamed: C62.1, CN4.SH, FB9.1, R45.1
unnamed: C705.2, R301.1, R701.2, U701.5
unnamed: C706.2, R302.1, R703.2, U702.5
unnamed: CN2.P1, U2.12
unnamed: CN2.P2, U2.11
unnamed: CN2.P3, U2.10
unnamed: CN2.P5, U2.9
unnamed: CN2.P7, U2.8
unnamed: CN2.P8, U2.7
unnamed: CN4.A4B9, CN4.B4A9, F1.2
unnamed: CN4.A5, R46.1
unnamed: CN4.B5, R47.1
unnamed: CN6.SH, FB5.1
unnamed: D1.1, R48.1
unnamed: D2.1, R44.2
unnamed: D3.2, R13.2, U301.K16
unnamed: L701.1, U702.3
unnamed: L702.1, U701.3
unnamed: R3.1, U301.D8
unnamed: R6.2, R7.1
unnamed: R10.2, U701.1
unnamed: R11.2, U301.P15
unnamed: R12.1, U301.E3
unnamed: R24.2, U6.9
unnamed: R25.2, U6.8
unnamed: R26.2, U6.7
unnamed: R30.1, U6.25
unnamed: R32.1, U6.11
unnamed: R33.1, U6.6
unnamed: R33.2, TP2.1
unnamed: R34.1, U6.10
unnamed: R35.2, TP4.1, Y3.1
unnamed: R36.1, Y3.3
unnamed: R37.2, R38.1
unnamed: R39.2, Y4.3
unnamed: R43.1, TP5.1, Y4.1
unnamed: R49.2, U301.A9
unnamed: R50.2, U301.C10
unnamed: R51.2, U301.A10
unnamed: R52.2, U301.D12
unnamed: R56.1, U301.P14
