owenosborn/imx6ulz-brain/(commit log)

2022-12-26 initial commit, r0
    [EX-PCB-10108-001-BOTTOM_4_Cu.gbr, EX-PCB-10108-001-B_Mask.gbr, EX-PCB-10108-001-B_Paste.gbr, EX-PCB-10108-001-B_SilkS.gbr, EX-PCB-10108-001-Cmts_User.gbr, EX-PCB-10108-001-Edge_Cuts.gbr, EX-PCB-10108-001-F_Mask.gbr, EX-PCB-10108-001-F_Paste.gbr]
2022-12-26 add power path header
    [EX-PCB-10108-001.kicad_sch, EX-PCB-10108-001_audio.kicad_sch, EX-PCB-10108-001_blockdiagram.kicad_sch, EX-PCB-10108-001_connector.kicad_sch, EX-PCB-10108-001_cpuperi1.kicad_sch, EX-PCB-10108-001_cpuperi2.kicad_sch, EX-PCB-10108-001_cpupwr.kicad_sch, EX-PCB-10108-001_dram.kicad_sch]
2022-12-26 routed power path controller
    [EX-PCB-10108-001.sch, EX-PCB-10108-001_connector.kicad_sch, EX-PCB-10108-001_connector.sch, EX-PCB-10108-001_cpuperi1.kicad_sch, EX-PCB-10108-001_cpuperi2.kicad_sch, EX-PCB-10108-001_storage.kicad_sch]
2022-12-27 r1 cam files
    [EX-PCB-10108-001-BOTTOM_4_Cu.gbr, EX-PCB-10108-001-B_Mask.gbr, EX-PCB-10108-001-B_Paste.gbr, EX-PCB-10108-001-B_Silkscreen.gbr, EX-PCB-10108-001-Edge_Cuts.gbr, EX-PCB-10108-001-F_Mask.gbr, EX-PCB-10108-001-F_Paste.gbr, EX-PCB-10108-001-F_Silkscreen.gbr]
2023-01-02 touch up sch
    [EX-PCB-10108-001_connector.kicad_sch]
2023-01-16 stencil for r1
    [EX-PCB-10108-001-B_Paste.gbr, EX-PCB-10108-001-F_Paste.gbr]
